chinochino66/humanoid/firmware/README.md

# firmware

## 収録物

| ファイル名 | 内容 | 状態 |
|---|---|---|
| ServoCenter.ino | サーボ中央出し・可動域確認治具 | 再作成版・実機未検証 |
| servo_pin_map.csv | PCA9685チャンネルと軸の対応表 | 再作成版・実測値未記入 |

**重要な注意**：両ファイルは手順書がL-Phase 1の成果物として挙げるものと同名だが、L1当時の原本は紛失している。本ファイルは現行設計（PCA9685 ×2構成）に合わせて2026-08-06に新規作成したものであり、L-Phase 1 の完了記録ではない。実機検証も未実施。実機で動作確認できた時点で、日付と結果をServoCenter.inoのヘッダへ追記すること。詳細は docs/OPEN_ISSUES.md #38 を参照。

## 動作確認の前提

- Adafruit PWM Servo Driver Library v2.4.0以降が必要
- ボードはArduino Mega 2560

## 安全上の注意

- サーボは機構へ取り付ける前に単体で中央出しすること
- ポンプ・高トルクサーボをArduinoの5V端子から給電しないこと
