chinochino66/humanoid/docs/channel_map.md

# チャンネル表 v1（頭部フェーズ）

準拠: `蓮冥頭部 H-Phase 0-24 改訂手順書`（2026-08-03改訂）
電源グループは `power_system.md` と対応。

**構成（制御四層）**

| 層 | 実体 | 役割 | 状態 |
|---|---|---|---|
| 第1層 | 胴体内AIコンピュータ（未選定） | 音声認識・LLM・TTS・視覚・ログ | **未実装**（暫定でノートPCが代行） |
| 第2層 | Arduino Mega | サーボ指令、位置・電流取得、状態機械 | 実装中 |
| 第3層 | 独立安全コントローラ（未選定） | 非常停止・漏水・過電流・過熱・WDT・電源遮断 | **未実装**（暫定でMegaが兼務） |
| 第4層 | LiFePO4 + BMS | 残量・温度監視、低電圧シャットダウン | 未接続 |

⚠ **第3層の兼務は暫定。**Megaがハングすれば安全系も同時に死ぬ。H-Phase 12で分離する。

---

## 1. I²Cアドレスマップ（第2層バス）

| アドレス | デバイス | バス | 設定 |
|---|---|---|---|
| 0x29 | TCS34725（カラー） | ESP32 | 固定 |
| 0x40 | PCA9685 #1 | Mega | ジャンパ無し |
| 0x41 | PCA9685 #2 | Mega | A0ハンダ |
| 0x44 | INA219 #A（レールA監視） | Mega | A1ジャンパ |
| 0x45 | INA219 #B（レールB監視） | Mega | A0＋A1ジャンパ |
| 0x48 | ADS1115（味覚AD） | ESP32 | ADDR→GND |
| 0x49 | ADS1115 増設予約 | ESP32 | ADDR→VDD |

⚠ **INA219のデフォルトは0x40でPCA#1と衝突する。必ず0x44/0x45へ変更してから接続。**

## 2. PCA9685 #1（0x40）— 表情系／レールA（5.8V・micro専用）

| ch | 制御名 | サーボ | 初期角 | パルスmin/max（実測欄） | 備考 |
|---|---|---|---|---|---|
| 0 | upperLip | MG92B | 90° | ／ | 皮膚アンカー荷重あり |
| 1 | cheekRight | MG92B | 90° | ／ | 〃 |
| 2 | cheekLeft | MG92B | 90° | ／ | 〃 |
| 3 | eyebrowRight | SG92R | 90° | ／ | |
| 4 | eyebrowLeft | SG92R | 90° | ／ | |
| 5 | forheadRight | SG92R | 90° | ／ | |
| 6 | forheadLeft | SG92R | 90° | ／ | |
| 7 | eyeX | MG90S | 90° | ／ | 両目左右・共通軸（i2Eyesは左右連動） |
| 8 | eyeY | MG90S | 90° | ／ | 両目上下・共通軸 |
| 9 | eyelidLeft | MG90S | 90° | ／ | |
| 10 | eyelidRight | MG90S | 90° | ／ | |
| 11 | tasteSensorLift | MG92B | 90° | ／ | 味覚プレート昇降 |
| 12-15 | 予備 | — | — | — | 独立視線化(v2)・唾液系の増設枠 |

**表情固定点はJMI-v1（顎交換境界）の外側に置く。**顎モジュールを交換しても表情機構が失われないこと（H-Phase 7完了ゲート）。

## 3. PCA9685 #2（0x41）— 首・顎系／レールB（5.0V・D36V50F5）

| ch | 制御名 | サーボ | 初期角 | 角度リミット | 備考 |
|---|---|---|---|---|---|
| 0 | neckRotate | **保留** | 90° | 小角度から実測 | 単軸駆動ルール適用 |
| 1 | neckUpDown | **保留** | 90° | 90±5°から開始 | 〃 |
| 2 | jaw | MG996R/DS3218（選定中） | 閉=0基準 | 試験15°／**上限20°をハードコード** | 首と同時駆動禁止。機械ストッパー併用 |
| 3 | throatGate | MG92B | **閉位置** | 実測 | **通常時クローズ。非通電時も閉じる機構が必要** |
| 4 | （予約）rollNeckRight | — | — | — | i2の首傾げを将来採用時 |
| 5 | （予約）rollNeckLeft | — | — | — | 〃 |
| 6-15 | 予備 | — | — | — | 唾液系など将来枠 |

⚠ 首サーボは `FutureJaw_MassEnvelope_v0` 確定まで発注しない（`servo_comparison.md` §6）。

## 4. Arduino Mega ピン（第2層）

| ピン | 機能 | 方向 | 備考 |
|---|---|---|---|
| D2 | mouthTrayDetect | IN（PULLUP） | トレー装着スイッチ。未装着＝口内系コマンド拒否 |
| D3 | tankFullSensor | IN（PULLUP） | 回収タンク満水 |
| D4 | **PCA_OE**（#1・#2共通） | OUT | HIGH=全サーボ出力停止。起動時HIGH、中立書込後にLOW |
| D5 | drainPump（MOSFET ch1） | OUT/PWM | ソフトタイマで連続駆動時間を制限 |
| D6 | foodTransferPump（MOSFET ch2） | OUT/PWM | 将来 |
| D7 | washPump（MOSFET ch3） | OUT/PWM | 将来 |
| D8 | **jawModuleID bit0** | IN（PULLUP） | 顎モジュール識別 |
| D9 | **jawModuleID bit1** | IN（PULLUP） | 〃（00=表情顎／01=咀嚼顎／11=未装着） |
| D10 | **安全系ハートビート出力** | OUT | 第3層のWDTへ。停止すれば遮断 |
| D11 | **安全系ステータス入力** | IN | 第3層からの遮断状態通知 |
| D18 | E-STOP状態（NO接点） | IN（PULLUP） | 状態通知のみ。**遮断は第3層が物理的に行う** |
| A0 | 漏水センサー1 | IN | 口内トレー直下 |
| A1 | 漏水センサー2 | IN | 頭蓋内・電装区画 |
| A2 | 漏水センサー3 | IN | 回収タンク周辺 |
| A3 | **基板温度センサー** | IN | 過熱監視 |
| D20/D21 | SDA/SCL | I²C | PCA×2＋INA×2 |
| （予約）D14/D15 | **Serial3 → CAN or RS-485** | — | 第1層との通信。ECI-v1 |
| USB Serial0 | 保守用リンク | — | **通常運転経路に含めない**。開発・更新・ログ回収のみ |

## 5. ESP32 味覚センサノード

| ピン | 機能 | 備考 |
|---|---|---|
| GPIO21/22 | SDA/SCL | ADS1115（0x48）、TCS34725（0x29） |
| ADS1115 A0 | pHモジュール | 校正液3点（4.00/6.86/9.18）で較正 |
| ADS1115 A1 | TDS（KS0429） | |
| ADS1115 A2 | VOC | I²C型なら空けてバス接続 |
| ADS1115 A3 | 予備 | |
| GPIO4 | 防水温度センサー | DS18B20系ならOneWire＋4.7kΩ。**型式要確認** |
| UART | 第1層へ味覚メッセージ送信 | 将来CAN/RS-485へ統合可 |

**TasteCell_v1は交換式とし、将来の脂質/高分子膜センサーアレイを追加できる電極・流路空間を確保する**（H-Phase 11）。

### 味覚JSONスキーマ v2

```json
{
  "ts": 0,
  "raw":        { "ph_mv": 0, "tds_mv": 0, "temp_c": 0, "rgb": [0,0,0], "voc_mv": 0 },
  "calibrated": { "ph": 0.0, "ec_us_cm": 0, "temp_c": 0.0 },
  "estimated":  { "sourness": 0.0, "saltiness": 0.0, "sweetness": 0.0, "aroma": 0.0 },
  "confidence": 0.0,
  "flags":      { "sensor_fault": false, "uncalibrated": false, "rinse_required": false }
}
```

**raw / calibrated / estimated / confidence を分離する。**pHを酸味、導電率をイオン量、VOCを香りの手掛かりとして扱い、**五味そのものと断定しない**（H-Phase 11）。

## 6. 表情プリセット

`neutral` ／ `angry` ／ `suspicious` ／ `thin_smile` ／ `taste_dislike` ／ `taste_approve`

**顎モジュールIDに応じてjawとupperLipの制限値を切り替える**（`JawModule_ProfileSchema_v1`）。プリセット再生は第2層で完結し、第1層が停止していても実行できること。

## 7. 固定安全ロジック（AI・LLMに委譲しない層）

| # | 条件 | 検知 | 固定動作 | 担当層 |
|---|---|---|---|---|
| 1 | 漏水 | A0〜A2 閾値超え | **喉ゲートを閉位置へ駆動 → 完了確認 → OE=HIGH → 全ポンプOFF → アクチュエータ電源遮断** | 第3層 |
| 2 | トレー未装着 | D2 | 口内系コマンド（JAW_OPEN含む）拒否 | 第2層 |
| 3 | タンク満水 | D3 | 食品受入停止。DRAIN系以外の口内系拒否 | 第2層 |
| 4 | E-STOP押下 | 物理NC接点 | **アクチュエータ電源を物理遮断。**手動確認まで再始動禁止 | 第3層 |
| 5 | ポンプ連続駆動超過 | ソフトタイマ | 強制OFF＋詰まり疑いフラグ | 第2層 |
| 6 | レール過電流 | INA219 が2A超×2秒 | 該当レールのサーボ停止 | 第2層→第3層 |
| 7 | **過熱** | A3 が閾値超え | 新規動作禁止 → 中立復帰 → 遮断 | 第3層 |
| 8 | **通信断（第1層）** | 受信タイムアウト | **新規動作禁止。中立保持または力解放** | 第2層 |
| 9 | **ハートビート停止（第2層）** | D10 のWDT | アクチュエータ電源遮断 | 第3層 |
| 10 | **BMS低電圧** | BMS通知 | 新規動作禁止 → ログ保全 → 制御シャットダウン | 第3層 |
| 11 | **モジュールID不明** | D8/D9 | **顎駆動へ電力を供給しない** | 第3層 |
| 12 | 待機タイムアウト | ソフトタイマ | OE=HIGH（保持電流遮断）。復帰は OE=LOW→目標角 | 第2層 |

**#1の順序が重要。**先にOE=HIGHにすると喉ゲートを閉じられなくなる。**閉じてから止める。**

**#4と#9は電気的に第2層から独立していること。**Megaがハングしても働くこと（H-Phase 12完了ゲート）。

## 8. 顎モジュールモード

| モード | 条件 | 顎駆動 |
|---|---|---|
| `EXPRESSION_JAW` | ID=00 | 表情・発話・味見のみ。**咀嚼不可** |
| `TASTE_ONLY` | 任意 | 顎は最小開口。味覚測定のみ |
| `MASTICATION_BENCH` | ID=01 かつ 頭部外 | ベンチ治具でのみ許可 |
| `MASTICATION_INSTALLED` | ID=01 かつ 全安全条件成立 | H-Phase 20以降 |

**表情顎では咀嚼モードへ遷移できない**（H-Phase 13完了ゲート）。

---

## 9. 未決

- [ ] 第3層マイコンの選定とピン割当
- [ ] CAN / RS-485 トランシーバの選定（ECI-v1）
- [ ] 喉ゲートの非通電時閉機構（ばね等）
- [ ] 基板温度センサーの実装位置と閾値
- [ ] 首サーボ確定後、ch0/ch1の角度リミットを実測で埋める
- [ ] パルスmin/max実測欄をキャリブレーション時に記入

## 変更履歴

- **v1 2026-08-03** 改訂手順書へ準拠。制御四層を明記、独立安全コントローラを追加、モジュールID・ハートビート・温度・CAN予約ピンを追加、固定安全ロジックを6→12条件へ拡張（漏水時の喉ゲート閉順序を明記）、味覚JSONスキーマv2と表情プリセットと顎モジュールモードを追加、サーボ型番を荷重帯で分割、レールBを5.0Vへ修正。ファイル名からバージョンを除去
- v0.1 2026-07-29 Eyes i2確定によりPCA#1を4ch削減
- v0 2026-07-28 初版
