chinochino66/humanoid/docs/servo_comparison.md

# サーボ仕様比較 v1（頭部フェーズ／スケール100%）

準拠: `蓮冥頭部 H-Phase 0-24 改訂手順書`（2026-08-03改訂）
採用スケール **100%** のため、InMoov公式指定のトルク基準がそのまま適用できる。

---

## 0. 選定方針

1. **荷重帯でサーボを分ける。**17軸を同一型番で揃える必要はない
2. **首サーボは将来の咀嚼顎質量を織り込むまで確定しない**（§6参照）
3. **公称値には条件がつく。**条件を書かない数値は採用しない
4. 電源はレールA=5.8V／レールB=5.0Vを前提とする（`power_system.md` §4）

---

## 1. 手持ち・到着待ち

| 型番 | 状態 | サイズ級 | 電圧 | ストールトルク | 速度 | 方式 | 重量/寸法 | 割り当て |
|---|---|---|---|---|---|---|---|---|
| MG90S ×4 | 到着待ち | micro | 4.8〜6V | 1.8kg·cm@4.8V／2.2@6V | 約0.1s/60° | アナログ・金属ギア | 13.4g／22.5×12×28.5mm | **目2軸＋瞼2軸に充当** |
| JX PDI-6225MG-300° | 到着待ち | 標準 | 4.8〜6.6V | 19.9kg·cm@4.8V／25.3@6V | 0.21s/60°@6V | デジタル・金属ギア・可動295°（500-2500µs） | 62g／40.5×20.2×38mm | **ハンド指駆動用に確保。頭部に流用しない** |

- 6225MGの「300°」は指の巻き取り量確保のための広角仕様。頭部関節は180°で足り、流用メリットが無く、PCA9685のパルス→角度換算も他と揃わなくなる
- ストール電流は公称なし。目安: micro級 〜0.7A@6V、25kg級 2.5〜3A@6V

## 2. 頭部の必要チャンネルと要求トルク帯（計16ch）

| トルク帯 | チャンネル | 数 |
|---|---|---|
| micro級（〜2.5kg·cm） | eyeX／eyeY／eyelid×2／eyebrow×2／forhead×2 | 8 |
| micro級（〜3.5kg·cm・皮膚荷重あり） | upperLip／cheek×2／throatGate／tasteSensorLift | 5 |
| 中型（10〜20kg·cm） | jaw | 1 |
| 大型（要検討） | neckRotate／neckUpDown | 2 |

**Eyes i2は左右連動構成のため、目2軸＋瞼2軸の計4軸。**独立視線化はi2フレーム外の上位機構であり、v2以降の課題とする。

## 3. InMoov公式指定（Default Hardware Map）

| 部位 | 公式指定 | 公式代替 | 補足 |
|---|---|---|---|
| Neck＋RotHead | HS-805BB ×2 | PDI-HV2060MG | ジャイアントスケール（約66×30×57.6mm）。**首まわりの印刷ホルダはこのサイズ前提** |
| Jaw | HK15298B ×1 | PDI-6221MG（180°版） | 可動は**0〜20°程度まで**（超過で破損リスク） |
| Eyes | SG92R ×2 | DS929HV | 左右連動の2サーボ構成 |
| RollNeck（i2の首傾げ） | HK15298B ×2 | PDI-6221MG（180°版） | 未採用。将来採用ならPCA#2の予備chへ |

- HS-805BB参考値: 19.8kg·cm@4.8V／24.7@6V、アナログ、約152g
- 公式サイトには、JX PDI-6221MG 180°を使用した際にServoAdapter・ServoHorn Adapter・SkullServoFixへ収まらず、SkullServoFixが2mm高くなったという報告がある。**i2Headのサーボ穴は公式指定寸法にぴったり作られている。数mmの差が命取りになる**

## 4. 購入候補比較

| 型番 | 電圧 | トルク | 速度 | 方式 | サイズ | 用途候補 | 備考 |
|---|---|---|---|---|---|---|---|
| **SG92R** | 4.8〜6V | 1.6kg·cm@4.8V | 0.1s/60° | アナログ | micro | 眉・額・瞼 | 公式が目に指定。低荷重軸には十分 |
| **MG92B** | 5〜6.6V | 3.5kg·cm | 0.08s/60° | アナログ・金属ギア | micro | 上唇・頬・喉ゲート・味覚リフト | **高さ31mm（MG90Sより2.5mm高い）。要実測** |
| MG90S | 4.8〜6V | 2.2kg·cm@6V | 0.1s/60° | アナログ・金属ギア | micro | 目・瞼 | 到着待ち4個を充当 |
| MG996R | 4.8〜6.6V | 9.4@4.8V／11@6V | 0.17s/60° | アナログ | 標準 | jaw（最安案） | 個体差大。顎は小角度運用なので十分 |
| DS3218MG | 4.8〜6.8V | 19@5V／21.5@6.8V | 0.16s/60° | デジタル | 標準 | jaw（余裕案） | 防水。5V動作でも19kg·cm |
| DS3225MG級 | 4.8〜6.8V | 21@5V／25@6.8V | 0.15s/60° | デジタル | 標準 | neck候補 | **ジャイアントスケールではない。ホルダ互換要確認** |
| HS-805BB | 4.8〜6V | 24.7@6V | — | アナログ | ジャイアント | neck候補 | 高価・入手性△。印刷パーツにそのまま合う |

⚠ **レールBは5.0V固定。**上表の「@6V」「@6.8V」の値は使えない。**5V時の値で評価すること。**HS-805BBは5V時に約20kg·cm相当まで落ちる。

⚠ 通販の商品説明ではMG90Sのトルクが1.8〜4.8kg·cmまで散らばっている。**ストール電流とデッドバンドまで記載のある出品だけがデータシートを見て書いている。採用値は2.2kg·cm@6V。**

## 5. 割り当て案 v1

| 用途 | ch数 | 使う物 | 追加購入 |
|---|---|---|---|
| 目（eyeX／eyeY） | 2 | 到着待ちMG90S | — |
| 瞼（左右） | 2 | 到着待ちMG90S | — |
| 眉×2・額×2 | 4 | — | **SG92R ×6**（予備2込み） |
| 上唇・頬×2・喉ゲート・味覚リフト | 5 | — | **MG92B ×6**（予備1込み・※高さ実測後） |
| jaw | 1 | — | **MG996R or DS3218 ×2**（予備込み） |
| neckRotate／neckUpDown | 2 | — | **保留（§6）** |
| 制御基板 | — | — | **PCA9685 ×2** |
| 配線 | — | 手持ち5＋到着5 | 首用22AWG＋micro用を追加 |

## 6. 首サーボ選定を保留する理由 ★

**改訂手順書 H-Phase 2 は、将来の咀嚼顎の質量ダミーを載せた許容領域（`FutureJaw_MassEnvelope_v0`）の作成を求めている。**

現在の頭部に加えて、H-Phase 20では以下が追加される。

- 金属サブフレームの咀嚼顎
- 交換式人工歯、舌パドル
- 荷重センサー、人工唾液回路
- 下顎外装・下顎シリコン皮膚

**今の頭部質量だけで首サーボを確定すると、H-Phase 20で首ごと作り直しになる。**手順書の「1からやり直しになる条件」に該当する。

**判定に必要なもの（H-Phase 2で取得する）**

1. 現在の頭部質量と重心位置の実測
2. `FutureJaw_MassEnvelope_v0` による将来質量・重心の想定値
3. 首の回転軸から重心までの距離 → 必要トルクの計算
4. NeckServoHolderV2 / SkullServoFixV5 の実寸とサーボ外形の照合
5. レールB 5.0V動作時のトルク低下（公称6V比で約2割減）の織り込み

**上記が揃うまで、首サーボは発注しない。**

## 7. 顎の角度リミット

| 項目 | 値 | 根拠 |
|---|---|---|
| 試験手順 | 閉口 → 5° → 10° → **15°** | 改訂手順書 H-Phase 5 |
| ハードコード上限 | **20°** | InMoov公式注記（超過で破損リスク） |
| 同時駆動 | 首との同時駆動を禁止 | レールB電流予算 |

**試験は15°まで。上限20°はソフトウェア側の絶対リミット。**両者を混同しないこと。加えて**機械ストッパーとソフトウェア制限の両方**を働かせる（H-Phase 5完了ゲート）。

## 8. 決めること

1. **MG92Bの高さ31mmを、印刷済みサーボマウントに実測で当てる**（入らなければSG92RかMG90Sへ変更）
2. 頭部質量・重心の実測と `FutureJaw_MassEnvelope_v0` の作成 → 首サーボ確定
3. jawをMG996R（安価）とDS3218（余裕）のどちらにするか
4. 将来の咀嚼顎アクチュエータは本表の対象外。H-Phase 15の要求仕様策定後に別途選定する

---

## 変更履歴

- **v1 2026-08-03** 改訂手順書へ準拠。Eyes i2確定によりmicro級を17→13軸へ、荷重帯でMG92B/SG92Rに分割、レールB5V化に伴い評価電圧を修正、首サーボ選定を将来顎質量エンベロープ確定まで保留、顎の試験角度と上限を分離。ファイル名からバージョンを除去
- v0 2026-07-28 初版

参考: inmoov.fr/default-hardware-map ／ inmoov.fr/neck-and-jaw ／ inmoov.fr/headi2
