chinochino66/humanoid/docs/reference/servo_datasheets.md

# サーボ諸元表

版数: v1.6
改訂日: 2026-08-06
準拠文書: 器創造計画 2026-2033（改訂基準日 2026-08-03）
系統タグ: 系統非依存（参照専用の仕様表。軸割当・系統タグはここには書かない）
変更履歴:
- v1 2026-08-04 旧H-Phase体系文書 `docs/archive/2026-08-03_servo_comparison_hphase.md` から、軸割当を含まない純粋な仕様表として新規分離。全数値をメーカー公式ページまたは特定リスティングの一次情報で再確認し、出典URL・取得日を付した。データシートに5.0V欄が無い機種は4.8V/6.0V（または5.0V/6.8V）からの線形補間であることを明記した。
  - JX PDI-1109MGを追加。InMoov公式 `inmoov.fr/eyes-i2/` の指定サーボであることを一次情報で確認（`docs/decisions/2026-08-04_eye_axis_count_correction.md` 参照）。
- v1.2 2026-08-06 HS-805BBの項目へ外形実寸（65.6×29.6mm、myminifactoryのコミュニティ情報。公式チュートリアル記載値66×30×57.6mmとは別記）を追記し、SkullServoFixV5ポケット実測値（65.7/29.3、2026-08-06）との整合を記録した【2026-08-06訂正：当初NeckServoHolderV2と記載したが誤り】。JX PDI-6221MG（顎駆動、InMoov公式i2Head指定）を新規追加。トルク・速度・電流・パルス仕様は未確認のまま登録した。
- v1.3 2026-08-06 JX PDI-6221MGへストールトルク（4.8V: 17.25kg·cm／6.0V: 20.32kg·cm／5.0V線形補間の推定値: 約17.8kg·cm）、動作速度（4.8V: 0.18秒/60°／6.0V: 0.16秒/60°）、外形寸法（40.5×20.2×38mm）、重量（62g）、ベアリング（2BB）を追記した。出典は販売店の商品説明（2026-08-06取得）でありメーカー公式データシートによる確認は未実施。本製品には動作角120°／180°／360°の別モデルが存在し、公式指定は180°だが現物（2026-08-06調達済み）が180°版であるかの確認は未実施（`docs/OPEN_ISSUES.md` #11 で継続管理）。

**本書の位置づけ**：この文書は各サーボ型番の仕様のみを扱う。どの軸にどのサーボを割り当てるかは `docs/L/servo_assignment_L.md`（L系）・`docs/R/reserved_axes.md`（R系・在庫紐付けのみ）・`docs/S/bench_axes_S3S4.md`（S系）を参照すること。

**数値の扱い**：
- データシート値と実測値は列を分ける。実測値欄が空の場合は「未実測」。
- 出典が確認できない数値は「未確認」と書く。他サイトからの孫引きは避ける。
- レールA=5.8V／レールB=5.0Vで運用するため、5.0V時の値を必ず併記する。メーカー公式に5.0V欄が無い場合は隣接する公式値からの線形補間とし、「補間・未実測」と明記する。補間は同一メーカー資料内の2点間の直線近似であり、実際のトルク–電圧特性が線形であることを保証しない。

---

## 1. 基本定格

| 型番 | メーカー | 動作電圧範囲 | ギア材質 | 外形 L×W×H | 質量 | 出典URL | 取得日 |
|---|---|---|---|---|---|---|---|
| MG90S | TowerPro | 4.8–6.6V | 金属（アルミ6061-T6、公式記載） | 22.8×12.2×28.5mm（公式ページのA-K多点寸法表の読み取りに複数系統の値があり、独立した複数サイトで一致するこの値を採用。公式図面での再確認が必要） | 13.4g | https://towerpro.com.tw/product/mg90s-3/ | 2026-08-04 |
| SG92R | TowerPro | 4.8V（公式は単一電圧表記のみ。上限側の公式記載なし） | POM＋カーボンファイバー | 34.5×22.8×26.7mm（公式A/B/C寸法） | 9g | https://towerpro.com.tw/product/sg92r-7/ | 2026-08-04 |
| MG92B | TowerPro | 5.0–6.6V | 金属 | 22.8×12×31mm | 13.8g | https://towerpro.com.tw/product/mg92b/ | 2026-08-04 |
| MG996R | TowerPro | 4.8–6.6V | 金属 | 40.7×19.7×42.9mm | 55g | https://towerpro.com.tw/product/mg996r/ | 2026-08-04 |
| DS3218MG | ANNIMOS（DS3218系OEM品。ベンダーにより仕様表記が異なる。下記は当該リスティングの記載値） | 出典により4.8–7.2V／5–6.8V等の表記差あり | 金属（フルメタルギア、防水） | 40×20×40.5mm | 60g | https://www.amazon.com/DS3218-Digital-Servo-Torque-Waterproof/dp/B07TKTQ2NZ | 2026-08-04 |
| HS-805BB | Hitec | 4.8–6.0V | ギアはナイロン、モータはカーボンブラシ | 66×30×57.6mm | 152g（5.36oz） | 一次PDF: https://www.hiteccs.com/public/uploads/data_sheet/HS-805BB-DataSheet-1642819052.pdf（機械抽出不可）／小売サイト記載値で代用: https://www.robotshop.com/products/hs-805bb-giant-scale-servo-motor | 2026-08-04 |
| JX PDI-1109MG | JX Servo | 4.8–6.0V | 金属（20T） | 23.2×12.0×24.8mm | 10g | https://inmoov.fr/eyes-i2/（InMoov公式指定。「4 servos JX PDI 1109MG」「avoid using cheap SG90, they won't last long」と明記）／数値照合: https://hobbyking.com/en_us/jx-pdi-1109mg-metal-gear-digital-micro-servo-2-5kg-0-10sec-10g.html | 2026-08-04 |
| JX PDI-6221MG | 未確認 | 未確認 | 未確認 | 40.5 × 20.2 × 38mm（標準サイズサーボ） | 62g | InMoov公式 i2Head チュートリアル（顎駆動サーボとして指定。動作角180°の記載あり） https://inmoov.fr/headi2/／外形・質量は販売店の商品説明（2026-08-06取得、メーカー公式データシートによる確認は未実施） | 2026-08-06 |

**HS-805BB 外形寸法の実寸との照合**

- 外形寸法（公式チュートリアル記載）: 66 × 30 × 57.6 mm
- 外形寸法（実寸）: 65.6 × 29.6 mm
  出典: myminifactory「InMoov Neck Servo Adaptor」(Brian Stott) の記述
  「HS805BB servo motors of dimension - 29.6mm X 65.6mm」
  **注記: 公式一次情報ではなくコミュニティ情報である。**
  ただし SkullServoFixV5 のポケット実測値（65.7 / 29.3、2026-08-06）と整合しており、
  設計上の想定サーボがHS-805BBであることの裏付けとなる（`docs/L/print_record_L.md` §3）。
  Hitec公式データシートによる寸法の確認は未実施。
  なお NeckServoHolderV2（外形 55.0 × 58.5 × 22.0 mm）にはHS-805BBは収まらない。
  首上下軸のサーボは未確定である（`docs/OPEN_ISSUES.md` #39）。
  **【2026-08-06 訂正】** 上記の判断は誤りであった。NeckServoHolderV2.stlには同一形状のL字ブラケットが2個含まれており、
  スライサー表示の外形55.0×58.5×22.0mmは2個分の合計である（1個あたり約55.0×28.0×22.0mm）。
  構造はサーボを内包する箱ではなく左右から挟むブラケットであるため、厚み22mmはサーボ高さの制約にならない。
  InMoov公式 Hardware and BOM（https://inmoov.fr/default-hardware-map/、取得日2026-08-06）の
  「2x Hitec HS805BB HEAD (up/down, right/left)」の記載により、首上下軸もHS-805BBで確定した（`docs/OPEN_ISSUES.md` #39）。

公式用途: 首回転・首上下（InMoov公式 Hardware and BOM「2x Hitec HS805BB HEAD (up/down, right/left)」、
https://inmoov.fr/default-hardware-map/、取得日2026-08-06）。
公式が挙げる代替: PDI-HV2060MG、HS5805MG、HK15338（HK15338はモーター極性が逆で
分解して180°回転させる必要があり、抵抗の追加も要すると設計者が回答している）。

**JX PDI-6221MGについて**

InMoov公式 i2Head チュートリアルにより、顎駆動（公式指定）および首回転の小型サーボ代替
（ServoAdapter/ServoHornAdapter併用時）に用いられることが判明した。
出典: InMoov公式 i2Head チュートリアル（inmoov.fr/headi2/）。
電流・パルス仕様は未確認（下表参照）。トルク・速度・外形寸法・重量・ベアリングは以下のとおり判明した。

- ストールトルク（4.8V）: 17.25 kg·cm
- ストールトルク（6.0V）: 20.32 kg·cm
- **5.0V時（線形補間による推定値）: 約17.8 kg·cm**
- 動作速度（4.8V）: 0.18秒/60°
- 動作速度（6.0V）: 0.16秒/60°
- 外形寸法: 40.5 × 20.2 × 38mm（標準サイズサーボ）
- 重量: 62g
- ベアリング: 2BB
- 出典: 販売店の商品説明（2026-08-06取得）。**メーカー公式データシートによる確認は未実施。**

**⚠ 本製品には動作角の異なる複数のモデルが存在する（120°／180°／360°）。**
公式i2Headチュートリアルの指定は**180°**である。
2026-08-06に1個を調達済みだが、**現物が180°版であるかの確認は未実施**。
到着後に必ず確認し、結果を本項へ追記すること。
`docs/OPEN_ISSUES.md` #11 で継続管理する。

公式用途: 顎（HK15298Bの代替として設計者が明示的に許容。「make sure to get 180°」との注意付き）、
RollNeck（首傾げ、オプション機構）。

**HK15298Bについて**

判明している情報のみ記載し、未確認の項目は「未確認」と明記する。

- 用途: 顎（公式BOM指定）、RollNeck ×2（公式BOM指定）、手指 ×10（公式BOM指定）
- トルク: 約20kg·cm（設計者の記述「HK15298B (Strong torque 20kg , no noise, 90degree)」による。電圧条件の記載なし）
- 動作角: 90°
- 外形寸法・電流・5V時特性: 未確認
- 入手性: 設計者が2022年に「入手困難」との問い合わせに対しJX-PDIシリーズを推奨している
- 出典: https://inmoov.fr/default-hardware-map/（取得日2026-08-06）
- **本プロジェクトでは採用しない**（顎はJX PDI-6221MGを採用。RollNeckは未採用）

## 2. トルク・速度

| 型番 | トルク@4.8V | トルク@5.0V | トルク@6.0V | 速度 | 実測値欄 |
|---|---|---|---|---|---|
| MG90S | 1.8kg·cm（公式） | 約1.84kg·cm（4.8V/6.6V公式値間の線形補間、未実測） | 約2.07kg·cm（同補間、未実測） | 0.10s/60°@4.8V／0.08s/60°@6.0V（公式。トルクのアンカー電圧が6.6Vなのに対し速度のアンカーは6.0Vと異なる点に注意） | 未実測 |
| SG92R | 2.5kg·cm（公式） | 未確認（公式が4.8V単一値のみで上限側アンカーが無く補間不可） | 未確認（同） | 0.1s/60°@4.8V（公式） | 未実測 |
| MG92B | 未確認（公式は5.0V起点） | 3.1kg·cm（公式） | 3.5kg·cm（公式） | 0.13s/60°@5.0V／0.08s/60°@6.0V（公式） | 未実測 |
| MG996R | 9.4kg·cm（公式） | 約9.67kg·cm（4.8V/6.0V公式値間の線形補間、未実測） | 11kg·cm（公式） | 0.19s/60°@4.8V／0.15s/60°@6.0V（公式） | 未実測 |
| DS3218MG | 未確認（当該リスティングに記載なし） | 19kg·cm（当該リスティング記載） | 約20.4kg·cm（5.0V/6.8V記載値間の線形補間、未実測。アンカー電圧が5.0V・6.8Vであり4.8V/6.0Vの慣例と異なる点に注意） | 未確認（当該リスティングに速度記載なし） | 未実測 |
| HS-805BB | 19.8kg·cm（公式値、小売サイト記載） | 約20.6kg·cm（4.8V/6.0V公式値間の線形補間、未実測。`docs/archive/2026-08-03_servo_comparison_hphase.md` の「5V時に約20kg·cm相当」という記述と整合） | 24.7kg·cm（公式値、小売サイト記載） | 0.19s/60°@4.8V／0.14s/60°@6.0V | 未実測 |
| JX PDI-1109MG | 2.2kg·cm（複数リテール一致値） | 約2.25kg·cm（4.8V/6.0V値間の線形補間、未実測） | 2.5kg·cm（複数リテール一致値） | 0.12s/60°@4.8V／0.10s/60°@6.0V | 未実測 |
| JX PDI-6221MG | 17.25kg·cm（販売店記載、メーカー公式未確認） | 約17.8kg·cm（4.8V/6.0V記載値間の線形補間、未実測） | 20.32kg·cm（販売店記載、メーカー公式未確認） | 0.18s/60°@4.8V／0.16s/60°@6.0V（販売店記載） | 未実測 |

## 3. 電流

| 型番 | 無負荷電流 | 動作電流 | ストール電流 | 実測値欄 |
|---|---|---|---|---|
| MG90S | 未確認（TowerPro公式に電流記載なし） | 未確認 | 未確認（`docs/archive/2026-08-03_servo_comparison_hphase.md` にmicro級目安0.7A@6Vの記載はあるが型番固有値ではない） | 未実測 |
| SG92R | 未確認（TowerPro公式に電流記載なし） | 未確認 | 未確認 | 未実測 |
| MG92B | 未確認（TowerPro公式に電流記載なし） | 未確認 | 未確認 | 未実測 |
| MG996R | 10mA（公式。電圧条件の明記なし） | 170mA（公式。電圧条件の明記なし） | 1400mA（公式。電圧条件の明記なし） | 未実測 |
| DS3218MG | 4mA@5.0V（当該リスティング記載） | 未確認（無負荷回転時の電流記載なし） | 1.5A@5.0V／1.8A@6.8V（当該リスティング記載） | 未実測 |
| HS-805BB | 8.0mA（待機、小売サイト記載。Hitec公式PDFは機械抽出不可のため未検証） | 700mA（無負荷回転時、同上） | 未確認（メーカー非公表。`docs/archive/2026-08-03_servo_comparison_hphase.md` に25kg級目安2.5〜3A@6Vの記載はあるが型番固有値ではない） | 未実測 |
| JX PDI-1109MG | 未確認（inmoov.fr／小売サイトとも電流記載なし） | 未確認 | 未確認（micro級目安0.7A@6Vの一般値はあるが型番固有値ではない） | 未実測 |
| JX PDI-6221MG | 未確認 | 未確認 | 未確認 | 未実測 |

## 4. パルス仕様

| 型番 | パルス幅範囲 | 周期 | 回転角 | 実測値欄 |
|---|---|---|---|---|
| MG90S | 未確認（公式に記載なし） | 未確認 | 未確認（通販説明では180°表記が一般的だが未確認） | 未実測 |
| SG92R | 未確認 | 未確認 | 未確認（同上） | 未実測 |
| MG92B | 未確認 | 未確認 | 90°（片側45°）、フルトラベル時は360°まで可（公式記載） | 未実測 |
| MG996R | 未確認 | 未確認 | 未確認（通販説明では180°表記が一般的だが未確認） | 未実測 |
| DS3218MG | 未確認 | 未確認 | 270°（当該リスティング記載） | 未実測 |
| HS-805BB | 未確認 | 未確認 | 未確認（一般的なアナログサーボの可動域だが型番固有の公式記載は未確認） | 未実測 |
| JX PDI-1109MG | 未確認 | 未確認 | 未確認（一般的なマイクロデジタルサーボの可動域だが型番固有の公式記載は未確認） | 未実測 |
| JX PDI-6221MG | 未確認 | 未確認 | 180°（InMoov公式 i2Head チュートリアル記載） | 未実測 |

**パルス幅範囲・周期が「未確認」の型番が多い理由**：多くの安価なアナログ/デジタルRCサーボは、メーカー公式ページに標準的なPWM値（目安 500〜2400µs、周期20ms）を明記しない。業界慣習として広く使われる値であっても、当該型番のデータシートに明記が無い限り本書では「未確認」として扱う。PCA9685のパルス値は実測で較正すること（`docs/L/channel_map_L.md` 側で扱う）。

---

## 変更履歴

- **v1 2026-08-04** 旧H-Phase体系文書から軸割当を含まない仕様表として新規分離。数値をメーカー公式ページ・リスティングの一次情報で再確認。
- **v1.1 2026-08-06** `docs/L/channel_map_L2.md`・`docs/L/servo_assignment_L2.md` のリネームに伴い、本書内の相互参照を `docs/L/channel_map_L.md`・`docs/L/servo_assignment_L.md` へ更新した（内容の変更はない）。
- **v1.2 2026-08-06** HS-805BBへ外形実寸（65.6×29.6mm、myminifactoryのコミュニティ情報）を追記し、SkullServoFixV5ポケット実測値（65.7/29.3、2026-08-06）との整合を記録した【2026-08-06訂正：当初NeckServoHolderV2と記載したが誤り】。JX PDI-6221MG（InMoov公式i2Head指定の顎駆動サーボ、動作角180°）を新規追加。トルク・速度・電流・パルス幅は未確認。
- **v1.3 2026-08-06** JX PDI-6221MGへトルク（ストール4.8V/6.0V・5.0V線形補間推定値）、速度（4.8V/6.0V）、外形寸法、重量、ベアリングを追記した（出典: 販売店の商品説明、メーカー公式データシートによる確認は未実施）。動作角の異なる複数モデル（120°／180°／360°）が存在し、現物（2026-08-06調達済み）が公式指定の180°版であるかの確認が未実施であることを記録した（`docs/OPEN_ISSUES.md` #11）。
- **v1.4 2026-08-06** HS-805BB実寸の裏付けとしていたポケット実測の部品名を訂正。実測した部品はNeckServoHolderV2ではなくSkullServoFixV5であった。NeckServoHolderV2（外形55.0×58.5×22.0mm）にはHS-805BBが収まらず、首上下軸のサーボは未確定である旨を追記した（`docs/OPEN_ISSUES.md` #39）。
- **v1.5 2026-08-06** v1.4の「NeckServoHolderV2にHS-805BBは収まらない」という判断を訂正。NeckServoHolderV2.stlに同一形状のL字ブラケットが2個含まれており、スライサー表示の外形55.0×58.5×22.0mmは2個分の合計（1個あたり約55.0×28.0×22.0mm）であったため、厚み22mmはサーボ高さの制約にならないと判明した。InMoov公式 Hardware and BOMにより首上下軸もHS-805BBで確定した旨を追記した（`docs/OPEN_ISSUES.md` #39）。
- **v1.6 2026-08-06** HS-805BBへ公式用途（首回転・首上下）と公式が挙げる代替（PDI-HV2060MG、HS5805MG、HK15338）を追記した。JX PDI-6221MGへ公式用途（顎の代替、RollNeck）を追記した。新規にHK15298Bの項目を追加した（顎・RollNeck・手指の公式指定サーボだが本プロジェクトでは不採用、`docs/OPEN_ISSUES.md` #11）。

## 参照一覧

| 資料 | URL | 取得日 |
|---|---|---|
| TowerPro MG90S 製品ページ | https://towerpro.com.tw/product/mg90s-3/ | 2026-08-04 |
| TowerPro SG92R 製品ページ | https://towerpro.com.tw/product/sg92r-7/ | 2026-08-04 |
| TowerPro MG92B 製品ページ | https://towerpro.com.tw/product/mg92b/ | 2026-08-04 |
| TowerPro MG996R 製品ページ | https://towerpro.com.tw/product/mg996r/ | 2026-08-04 |
| ANNIMOS DS3218 製品リスティング（Amazon） | https://www.amazon.com/DS3218-Digital-Servo-Torque-Waterproof/dp/B07TKTQ2NZ | 2026-08-04 |
| Hitec HS-805BB 一次データシートPDF（機械抽出不可、参照用） | https://www.hiteccs.com/public/uploads/data_sheet/HS-805BB-DataSheet-1642819052.pdf | 2026-08-04 |
| Hitec HS-805BB 記載仕様（小売サイト、上記PDF未検証分の代用） | https://www.robotshop.com/products/hs-805bb-giant-scale-servo-motor | 2026-08-04 |
| InMoov Eyes i2（JX PDI-1109MG指定、SG90級非推奨の警告） | https://inmoov.fr/eyes-i2/ | 2026-08-04 |
| JX PDI-1109MG 記載仕様（小売サイト、トルク・速度・寸法の照合用） | https://hobbyking.com/en_us/jx-pdi-1109mg-metal-gear-digital-micro-servo-2-5kg-0-10sec-10g.html | 2026-08-04 |
| InMoov Head i2（顎駆動サーボ JX PDI-6221MG・動作角180°の指定根拠） | https://inmoov.fr/headi2/ | 2026-08-06 |
| myminifactory「InMoov Neck Servo Adaptor」(Brian Stott)（HS-805BB実寸65.6×29.6mmの記載。※公式一次情報ではなくコミュニティ情報） | ローカル参照（URL未取得、記述内容のみタスク指示より転記） | 2026-08-06 |
| 旧文書 `docs/archive/2026-08-03_servo_comparison_hphase.md` | ローカルリポジトリ内 | 2026-08-03 |
