chinochino66/humanoid/docs/decisions/2026-08-04_eye_axis_count_correction.md

# 決定記録：目の軸数誤り（4軸誤認）の訂正

版数: v1.1
改訂日: 2026-08-06
準拠文書: 器創造計画 2026-2033（改訂基準日 2026-08-03）
系統タグ: 全系統（決定記録。L系文書群に波及）
変更履歴:
- v1 2026-08-04 新規作成

## 判断日

2026-08-04

## 誤りの内容

L/R/S/M体系への移行時（2026-08-04、コミット1〜7）、L2 InMoov頭部の目関連軸を「eyeX／eyeY（両目共通2軸）＋eyelidLeft／eyelidRight（瞼2軸）＝計4軸」として `docs/L/channel_map_L.md`・`docs/L/servo_assignment_L.md`・`docs/S/power_tree.md` に記載していた。

これは誤りだった。正しくは、InMoov公式のi2Eyes機構は**片目あたり4サーボ（眼球X/Y・上瞼・下瞼）×左右＝計8軸、かつ左右は機械的に連動せずソフトウェア同期**である。

## 発見経緯

「蓮冥頭部 開発手順書 Version 2.0」の部品表が「瞼×4→SG92R」としていたのに対し、リポジトリは瞼2軸（eyelidLeft／eyelidRight）としており、数量の不一致が生じていた。この不一致を一次情報で確認する過程で、`inmoov.fr/eyes-i2/` を直接確認した結果、瞼だけでなく眼球側も含めて軸数の誤認があったことが判明した（旧「eyeX/eyeY共通2軸」自体が誤りであり、正しくは眼球も左右独立4軸）。

**教訓（軸数確認の手順）**：当初は瞼の軸数（2か4か）についてWeb検索・AI要約で確認しようとしたが、`inmoov.fr/eyes-i2/` と `inmoov.fr/headi2/` の記述に見かけ上の矛盾があり（前者は「2 servos drive the eyelids」、後者はMyRobotLabの4チャンネル名を列挙）、一度は「未確認」として `docs/OPEN_ISSUES.md` #30 へ登録した。その後、部品表の見出し（「i2Eyes printed parts for **1 Right Eye**」＝片目分の記載であること）とネジ本数（3×10mmネジ8本＝片目4サーボ分の固定具と一致）まで踏み込んで確認したことで、誤認が解けた。

## 正しい軸数と根拠

出典: `inmoov.fr/eyes-i2/`、取得日 2026-08-04

- 部品表の見出しは「i2Eyes printed parts for 1 Right Eye」＝片目分の記載である
- 片目あたり4サーボ（main baseに2個＝眼球X/Y、side baseに2個＝上瞼・下瞼）
- 3×10mmネジ8本（main base 4本＋side base 4本）が片目4サーボの固定数と一致する
- 両目で計8サーボ。**眼球4軸・瞼4軸**
- 公式指定サーボは **JX PDI-1109MG**（「4 servos JX PDI 1109MG」と明記）
- 公式は「安価なSG90は避けろ、長持ちしない（avoid using cheap SG90, they won't last long）」と明記している
- i2Eyesは**左右独立サーボ**であり、機械的な連動ではなく**MyRobotLab側のソフトウェア同期**で左右を揃える設計である（作者Gael Langevinの記載）

## 波及した文書一覧

| 文書 | 変更内容 |
|---|---|
| `docs/L/channel_map_L.md` | L系チャンネル数を7ch→11ch（目8＋首2＋顎1）へ拡張。eyeX/eyeYの「両目左右共通軸」記述を削除し、eyeLeftX／eyeLeftY／eyeRightX／eyeRightY／eyelidLeftUpper／eyelidLeftLower／eyelidRightUpper／eyelidRightLowerの8ch（ch7-10, 12-15）を追加。空きチャンネル集計を再計算（PCA9685 #1は空きゼロに） |
| `docs/L/servo_assignment_L.md` | 対象軸を7軸→11軸へ拡張。候補型番にJX PDI-1109MGを追加し5.0V時トルクを一次情報で確認。SG92R使用の寿命リスクとMG90S×4本の不足を明記 |
| `docs/S/power_tree.md` | レールAの2026年実装範囲を4ch→8chへ修正。§6.1電流予算・§6.2稼働時間（定常約6.1時間→約4.7時間）・§7-5 PTC電圧降下を再計算。理論上限電流が2.8A→5.6Aとなり、LM2596の実用2A枠を大きく超えることを明記 |
| `docs/reference/servo_datasheets.md` | JX PDI-1109MGの諸元を新規追加（一次情報＋小売サイト照合） |
| `docs/OPEN_ISSUES.md` | #30を「未確認」から「解決済み」へ更新。新規に#31（目サーボ4本の追加調達、影響度高）・#32（左右独立サーボのソフトウェア同期実装、影響度中）・#33（瞼へのSG92R使用可否、影響度中）を追加 |

## 再発防止

- **軸数・数量の確認は、部品表の見出しの適用範囲（片目分か両目分か等）まで確認する。**「瞼×4」のような数量記載だけでなく、それが片側分か両側分かを取り違えると、実際の軸数を過小評価する。
- **組立手順のネジ本数・固定具数など、数量が独立に裏付けられる情報と突き合わせる。**本件では「3×10mmネジ8本＝片目4サーボ分」というネジ本数が、サーボ本数の傍証として機能した。数量の食い違いに気づいた際は、Web検索の要約だけで終わらせず、可能な限りこうした独立した裏付けを探すこと。
- **一次情報間で見かけ上の矛盾がある場合、「未確認」で済ませる前に、より詳細な記述（見出し・注記・数量根拠）まで読み込む。**本件では `eyes-i2/` と `headi2/` の記述の粒度の違い（ハードウェア台数 vs ソフトウェアチャンネル名）が矛盾に見えていただけで、実際には矛盾していなかった。

---

## 変更履歴

- **v1 2026-08-04** 新規作成。目の軸数誤り（4軸→8軸）の訂正記録。
- **v1.1 2026-08-06** `docs/L/channel_map_L2.md`・`docs/L/servo_assignment_L2.md` のリネームに伴い、本書内の相互参照を `docs/L/channel_map_L.md`・`docs/L/servo_assignment_L.md` へ更新した（内容の変更はない）。

## 参照一覧

| 資料 | URL | 取得日 |
|---|---|---|
| InMoov Eyes i2 | https://inmoov.fr/eyes-i2/ | 2026-08-04 |
| InMoov Head i2 | https://inmoov.fr/headi2/ | 2026-08-04 |
| `docs/L/channel_map_L.md` | ローカルリポジトリ内 | 2026-08-04 |
| `docs/L/servo_assignment_L.md` | ローカルリポジトリ内 | 2026-08-04 |
| `docs/S/power_tree.md` | ローカルリポジトリ内 | 2026-08-04 |
| `docs/reference/servo_datasheets.md` | ローカルリポジトリ内 | 2026-08-04 |
| `docs/OPEN_ISSUES.md` | ローカルリポジトリ内 | 2026-08-04 |
