chinochino66/humanoid/docs/S/i2c_address_map.md

# I²Cアドレスマップ

版数: v1.1
改訂日: 2026-08-06
準拠文書: 器創造計画 2026-2033（改訂基準日 2026-08-03）
系統タグ: S（安全・制御・知覚。頭部全体の第2層バス構成）
変更履歴:
- v1 2026-08-04 `docs/S/bench_axes_S3S4.md` §6で「担当文書未確定」としていたI²Cアドレスマップの全体像を新規文書として分離。PCA9685のAll Callアドレス重複の扱い（`docs/OPEN_ISSUES.md` 登録項目）を整理し、空きアドレス帯を明示した。

**本書の位置づけ**：頭部第2層（Arduino Mega）バス上のI²Cデバイス全体のアドレス割当を扱う。軸割当は `docs/L/channel_map_L.md`（L系）・`docs/R/reserved_axes.md`（R系）・`docs/S/bench_axes_S3S4.md`（S系）を参照。電源レール・電流監視の詳細は `docs/S/power_tree.md` を参照。

---

## 1. アドレス一覧

| アドレス | デバイス | バス | 用途 | 設定 |
|---|---|---|---|---|
| 0x29 | TCS34725（カラーセンサー） | ESP32 | 味覚ノード | 固定（変更不可） |
| 0x40 | PCA9685 #1 | Mega | サーボ制御（L系目・瞼／R系予約／S系tasteSensorLift） | ジャンパ無し（工場出荷時デフォルト） |
| 0x41 | PCA9685 #2 | Mega | サーボ制御（L系首・顎／S系throatGate） | A0ハンダジャンパを閉じる |
| 0x44 | INA219 #A（レールA電流監視） | Mega | `docs/S/power_tree.md` §5 | A1ジャンパを閉じる |
| 0x45 | INA219 #B（レールB電流監視） | Mega | `docs/S/power_tree.md` §5 | A0＋A1ジャンパを閉じる |
| 0x48 | ADS1115（味覚AD） | ESP32 | pH・TDS・VOC | ADDRピン→GND |
| 0x49 | ADS1115 増設予約 | ESP32 | 将来センサー追加用 | ADDRピン→VDD |
| 0x70 | PCA9685 #1／#2 共通 All Call（工場出荷時デフォルト有効） | Mega | §3参照。**両基板が同時応答する** | 無効化を推奨（§3） |

**INA219のデフォルトアドレスは0x40であり、PCA9685 #1と衝突する。**必ずA1ジャンパ（0x44）／A0+A1ジャンパ（0x45）へ変更してから接続すること。

## 2. 部品ごとのジャンパ・ハンダ変更箇所

| デバイス | 変更箇所 | 変更前（工場出荷時） | 変更後 |
|---|---|---|---|
| PCA9685 #1 | A0〜A5ジャンパパッド | 全開放（アドレス0x40） | **変更不要**（そのまま0x40として使用） |
| PCA9685 #2 | A0ジャンパパッド | 全開放（アドレス0x40） | A0パッドをハンダ短絡 → 0x41 |
| INA219 #A | A0・A1ジャンパ | 全開放（アドレス0x40、デフォルト） | A1ジャンパを短絡 → 0x44 |
| INA219 #B | A0・A1ジャンパ | 全開放（アドレス0x40、デフォルト） | A0・A1ジャンパを両方短絡 → 0x45 |
| ADS1115（味覚AD） | ADDRピン結線 | 未結線（フローティング、非推奨） | GNDへ結線 → 0x48 |
| ADS1115（増設予約） | ADDRピン結線 | 未結線 | VDDへ結線 → 0x49 |
| TCS34725 | なし | 0x29固定 | 変更不可（設定箇所なし） |

## 3. PCA9685のAll Callアドレス重複について

PCA9685は、個別アドレス（0x40／0x41）に加えて、**工場出荷時デフォルトで All Call アドレス 0x70 にも応答する。**MODE1レジスタ（0x00番地）のALLCALLビット（bit0）が出荷時 `1`（有効）のため、**本システムのPCA9685 #1・#2は両方とも0x70に同時応答する状態にある。**

### (a) 両基板同時応答の可否

0x70宛のI²C書き込みは、**PCA9685 #1・#2の両方に同時に作用する。**これは以下の場合に危険となり得る：

- ソフトウェアのバグや配線ミスで意図せず0x70へ書き込んだ場合、L系（目・瞼・首・顎）とR系予約・S系（喉ゲート等）の両基板のサーボが**同時に**動く
- E-STOP復帰時など、特定の基板のみへ中立値を書き込むつもりが、0x70経由で両基板に書き込まれる

一方、起動シーケンス（`docs/S/power_tree.md` §8）の「全chに中立値を書き込む」ステップのように、**両基板に同一内容を一括で書き込みたい場面では有用**な面もある。ただし、この起動シーケンスでは元々OE（出力イネーブル）ピンD4が両基板共通のハードウェア結線であり、出力停止・再開はI²Cを介さずピンレベルで既に両基板同時に制御できている。**All Callが無ければ起動シーケンスが成立しないわけではない。**

**本書の判断**：意図しない同時書き込みのリスクが、起動時一括書き込みの利便性を上回ると判断し、**両基板のAll Callを無効化することを推奨する。**

### (b) 無効化手順

Mega初期化時（OE=HIGHの間、§出力停止状態）に、両基板それぞれのMODE1レジスタのALLCALLビット（bit0）を`0`に書き込む。個別アドレス（0x40／0x41）でMODE1レジスタへアクセスするため、無効化そのものは基板ごとに独立して行える。

**この初期化コードは本書執筆時点で未実装。**`docs/OPEN_ISSUES.md` へ「PCA9685 All Callアドレス2枚重複の扱い」として登録済みの項目に対応する実装タスクとする。

### (c) Sub-callアドレスの扱い

PCA9685はAll Callの他に、Sub1／Sub2／Sub3の3つのグループアドレス（MODE1レジスタのSUB1／SUB2／SUB3ビット、デフォルトアドレスはそれぞれ0x71／0x72／0x74）を持つ。**これらは工場出荷時デフォルトで無効（ビット=0）であり、現状は両基板とも応答しない。**

将来、特定チャンネル群を同期駆動する目的でSub-callを有効化する場合、**両基板が同一のデフォルトアドレスに設定されると、All Callと同じ「両基板同時応答」の問題が再発する。**Sub-callを使う場合は、基板ごとに異なるSUBADRレジスタ値へ変更すること。本書時点では未使用（無効のまま）とし、有効化する際は本書を更新すること。

## 4. 空きアドレス帯

I²Cの7ビットアドレス空間は0x08〜0x77が汎用領域（0x00〜0x07と0x78〜0x7Fは予約用途）。現在使用中のアドレスは以下の通り：

**使用中**：0x29、0x40、0x41、0x44、0x45、0x48、0x49、（0x70はAll Call、§3参照）

**空きアドレス帯**：
- 0x08〜0x28
- 0x2A〜0x3F
- 0x42〜0x43
- 0x46〜0x47
- 0x4A〜0x6F
- 0x71〜0x77（うち0x71／0x72／0x74はPCA9685のSub-callデフォルトのため、Sub-call有効化時は要注意。§3(c)参照）

新規I²Cデバイスを追加する場合、上記の空きアドレス帯から選定し、本書を更新すること。

## 5. 未決事項

- [ ] PCA9685 All Callの無効化コードの実装（`docs/OPEN_ISSUES.md` 登録済み）
- [ ] Sub-callアドレスを将来使用する場合の基板ごとの割当方針の事前決定

---

## 変更履歴

- **v1 2026-08-04** `docs/S/bench_axes_S3S4.md` から分離して新規作成。All Callアドレス重複の扱いと空きアドレス帯を明示した。
- **v1.1 2026-08-06** `docs/L/channel_map_L2.md` のリネームに伴い、本書内の相互参照を `docs/L/channel_map_L.md` へ更新した（内容の変更はない）。

## 参照一覧

| 資料 | URL | 取得日 |
|---|---|---|
| NXP PCA9685 データシート（MODE1レジスタ、ALLCALL/SUB1/SUB2/SUB3ビット、ALLCALLADR/SUBADRデフォルト値の根拠） | https://www.nxp.com/docs/en/data-sheet/PCA9685.pdf | 2026-08-04 |
| `docs/S/power_tree.md` | ローカルリポジトリ内 | 2026-08-04 |
| `docs/L/channel_map_L.md` | ローカルリポジトリ内 | 2026-08-04 |
| `docs/R/reserved_axes.md` | ローカルリポジトリ内 | 2026-08-04 |
| `docs/S/bench_axes_S3S4.md` | ローカルリポジトリ内 | 2026-08-04 |
| 旧文書 `docs/archive/2026-08-03_channel_map_hphase.md` | ローカルリポジトリ内 | 2026-08-03 |
