chinochino66/humanoid/media/README.md

# media

## 用途

部品写真・試験動画の保存先。

## 命名規則

`L2_部品名_YYYY-MM-DD.jpg` の形式とする。

## 撮影時の注意

ノギスを当てた状態で撮ると寸法証拠を兼ねられる。

## LFS対象

`.jpg` / `.jpeg` / `.mp4` / `.mov`
