chinochino66/humanoid/docs/S/safety_logic.md

# 頭部全体の固定安全ロジック

版数: v1.2
改訂日: 2026-08-06
準拠文書: 器創造計画 2026-2033（改訂基準日 2026-08-03）
系統タグ: S（安全・制御・知覚。頭部全体、L系・R系・S系すべてに適用）
変更履歴:
- v1 2026-08-04 `docs/S/bench_axes_S3S4.md` §6で「担当文書未確定」としていた、頭部全体に関わる固定安全ロジック（ベンチ限定でない8条件）を新規文書として分離。第3層未実装によるMega兼務のリスクを明記した。
- v1.1 2026-08-06 第3層に在庫のArduino Mega 2560の2枚目を充てることを決定した旨を反映（`docs/decisions/2026-08-06_layer3_controller_selection.md`）。ただし実配線・ファームウェア・動作検証は未着手であり、共倒れ構造は現時点で解消していないことを明記した。部品表の在庫状況（Mega 2560×2枚、予備ゼロ）を注記し、第3層が担う機能（実装予定・未着手）を列挙した。

**本書の位置づけ**：ベンチ限定の安全ロジック（漏水・トレー未装着・タンク満水・ポンプ連続駆動超過）は `docs/S/bench_axes_S3S4.md` §4を参照。本書は頭部全体（L系・R系・S系すべて）に適用される固定安全ロジックを扱う。**AI・LLMに安全判断を委ねない**（`docs/S/power_tree.md` §0 設計方針2）。

---

## 1. 固定安全ロジック（頭部全体、計8条件）

| # | 条件 | 検知手段 | 固定動作 | 担当層 |
|---|---|---|---|---|
| 1 | E-STOP押下 | 物理NC接点 | **アクチュエータ電源を物理遮断。**手動確認まで再始動禁止 | 第3層 |
| 2 | レール過電流 | INA219（0x44／0x45）が2A超×2秒 | 該当レールのサーボ停止 | 第2層→第3層 |
| 3 | 過熱 | 基板温度センサー（Megaピン A3、10kΩ NTCサーミスタ＋分圧抵抗10kΩ。2026-08-06決定・未入手） | 新規動作禁止 → 中立復帰 → 遮断 | 第3層 |
| 4 | 通信断（第1層） | 受信タイムアウト | **新規動作禁止。中立保持または力解放** | 第2層 |
| 5 | ハートビート停止（第2層） | 安全系ハートビート出力（Megaピン D10）のWDT | アクチュエータ電源遮断 | 第3層 |
| 6 | BMS低電圧 | BMS通知 | 新規動作禁止 → ログ保全 → 制御シャットダウン | 第3層 |
| 7 | モジュールID不明 | jawModuleID bit0/1（Megaピン D8/D9） | **顎駆動へ電力を供給しない** | 第3層 |
| 8 | 待機タイムアウト | ソフトタイマ | OE=HIGH（保持電流遮断）。復帰は OE=LOW→目標角 | 第2層 |

**#1と#5は電気的に第2層から独立していること。**Megaがハングしても働くこと。

**条件番号について**：旧文書 `docs/archive/2026-08-03_channel_map_hphase.md` §7の12条件のうち、ベンチ限定の4条件（漏水／トレー未装着／タンク満水／ポンプ連続駆動超過）は `docs/S/bench_axes_S3S4.md` §4へ移した。本書の8条件は残りの頭部全体条件であり、旧文書の番号とは対応しない（本書内で#1〜#8として振り直した）。

## 2. 第3層未実装の現状とリスク

**第3層（独立安全コントローラ）は、2026-08-06に在庫のArduino Mega 2560の2枚目を充てることを決定したが（`docs/decisions/2026-08-06_layer3_controller_selection.md`）、本書執筆時点では実配線・ファームウェアともに未実装である。**上表で「担当層：第3層」とした条件（#1、#3、#5、#6、#7）は、暫定的に**Arduino Mega（第2層）が兼務**している。

**部品表の在庫状況**：Arduino Mega 2560は部品表で在庫2枚。1枚目は第2層（頭部リアルタイム制御）に使用、2枚目を第3層（独立安全コントローラ）に充てる。予備はゼロとなる。

**第3層が担う機能（実装予定・未着手）**：以下は上表（§1）で担当層を「第3層」とした条件に対応する。いずれも実装予定であり、現時点では未着手。

- 第2層からのハートビート受信と途絶検知（上表#5に対応）
- 途絶・異常検知時の電力枝の遮断（上表#1・#3・#5・#6・#7に対応）
- 異常解除後、手動確認なしに再始動させないラッチ保持（上表#1に対応）
- 非常停止入力の受け付け（通信バスおよびAI OSから独立）（上表#1に対応）

**兼務のリスク**：上表#5「ハートビート停止（第2層）」は、本来Megaのハング自体を検知して独立した第3層が電源を遮断する設計である。しかし第3層が未実装でMegaが兼務している現状では、**Megaがハングした場合、ハートビート監視自体もMega上で動作しているため機能しない。**つまり、最も検知したい故障モード（Megaのハング）そのものが、検知機構を道連れにして機能停止する「共倒れ」構造になっている。2026-08-06、第3層に在庫のArduino Mega 2560の2枚目を充てることを決定した（`docs/decisions/2026-08-06_layer3_controller_selection.md`）。実配線・ファームウェア・動作検証はいずれも未着手であり、現時点では共倒れ構造が解消されたわけではない。

**#2「レール過電流」も同じ構造の共倒れ対象である。**INA219（0x44／0x45）はMegaのI²Cバス上にあり、Megaがハングすればバスのポーリング自体が止まるため、レール過電流の検知そのものが機能しなくなる。上表で担当層を「第2層→第3層」としているのはこの一次検知（第2層）から第3層への遮断委譲を表すが、第3層が未実装の現状では一次検知が止まった時点で経路全体が機能停止する。

同様に、E-STOP（#1）は物理NC接点による遮断のためMega非依存で成立しうるが、実際の遮断段（アクチュエータ遮断段）の制御ロジックが第3層ではなく第2層（Mega）に暫定実装されている場合、Megaのハング中はE-STOP押下後の遮断シーケンスが正しく実行されない可能性がある。**この配線・実装が第2層に依存していないか、実機で確認すること。**

→ 独立安全コントローラ（第3層）の選定は `docs/OPEN_ISSUES.md`（影響度：高）に登録済み。選定・実装までは、上記の共倒れリスクを許容した暫定運用であることを、運用者・オペレータへ明示すること。

## 3. 未決事項

- [ ] 独立安全コントローラ（第3層）の選定（`docs/OPEN_ISSUES.md` 登録済み）
- [ ] E-STOP遮断シーケンスが第2層（Mega）に依存していないか、実機配線の確認
- [ ] 過熱閾値（基板温度センサーA3）の具体的な数値の決定（素子は10kΩ NTCサーミスタで決定済み。閾値は未定）
- [ ] BMS低電圧の具体的な閾値電圧の決定（BMS型式未選定、`docs/S/power_tree.md` §7-2参照）

---

## 変更履歴

- **v1 2026-08-04** `docs/S/bench_axes_S3S4.md` から分離して新規作成。第3層未実装によるMega兼務の「共倒れ」リスクを明記した。
- **v1.1 2026-08-06** 第3層に在庫のArduino Mega 2560の2枚目を充てることを決定した旨を反映（`docs/decisions/2026-08-06_layer3_controller_selection.md`）。ただし実配線・ファームウェア・動作検証は未着手であり、共倒れ構造は現時点で解消していないことを明記した。部品表の在庫状況（Mega 2560×2枚、予備ゼロ）を注記し、第3層が担う機能（実装予定・未着手）を列挙した。
- **v1.2 2026-08-06** §1の#3（過熱）の検知手段欄へ、採用素子（10kΩ NTCサーミスタ＋分圧抵抗10kΩ、2026-08-06決定・未入手）を追記した。§3未決事項の過熱閾値の行へ、素子確定済み・閾値未定である旨を追記した。

## 参照一覧

| 資料 | URL | 取得日 |
|---|---|---|
| `docs/S/power_tree.md` | ローカルリポジトリ内 | 2026-08-04 |
| `docs/S/bench_axes_S3S4.md` | ローカルリポジトリ内 | 2026-08-04 |
| `docs/S/mcu_pinmap.md` | ローカルリポジトリ内 | 2026-08-04 |
| `docs/S/i2c_address_map.md` | ローカルリポジトリ内 | 2026-08-04 |
| 旧文書 `docs/archive/2026-08-03_channel_map_hphase.md` | ローカルリポジトリ内 | 2026-08-03 |
