chinochino66/humanoid/docs/decisions/2026-08-06_layer3_controller_selection.md

# 決定記録：第3層（独立安全コントローラ）に充てるマイコンの選定

版数: v1
改訂日: 2026-08-06
準拠文書: 器創造計画 2026-2033（改訂基準日 2026-08-03）
系統タグ: S（安全・制御・知覚。頭部第3層マイコンの選定）
変更履歴:
- v1 2026-08-06 新規作成

## 判断日

2026-08-06

## 決定

第3層（独立安全コントローラ）に、在庫のArduino Mega 2560の2枚目を充てる。

## 背景

`docs/S/safety_logic.md` は、現状では第2層（頭部リアルタイム制御）のArduino Mega 2560が制御と安全監視を兼務しており、第2層のMegaがハングした場合に安全監視機構も同時に機能停止する「共倒れ」構造であると自ら指摘している（`docs/OPEN_ISSUES.md` #1、影響度：高）。部品表にはArduino Mega 2560が2枚あり、1枚目は既に第2層で使用済みだが、2枚目は未使用である。この2枚目を第3層専任に充てることで、追加調達なしにこの構造的欠陥を解消できる。

## 選定理由

(1) 追加調達が不要である。部品表にArduino Mega 2560が2枚あり、1枚目が第2層で使用済み、2枚目が未使用である。

(2) 第2層と同一アーキテクチャのため、開発環境・書き込み手順・デバッグ手法を共用できる。

(3) `docs/OPEN_ISSUES.md` #1 は影響度「高」でありながら、解決に費用がかからない唯一の項目である。

## 却下した代替案とその理由

(a) 専用の安全コントローラICまたは産業用安全リレーの採用 … 調達費用と選定期間が発生する。L系学習機の段階では過剰である。将来R系の製品化時に再評価する。

(b) 単一Megaのままウォッチドッグタイマのみで対応 … Mega自身がハングした場合に同一チップ上のWDTだけでは外部の電力遮断まで到達できる保証がなく、共倒れ構造が残る。

## 本決定の限界

Arduino Mega 2560は機能安全規格（ISO 13849 / IEC 61508 等）の認証を受けた安全コントローラではない。本決定はL系学習機における暫定措置であり、R系商用頭部では認証済みデバイスの採用を含めて再評価する。手順書 S-Phase 0 の完了ゲート「非常停止が通信バスとAI OSから独立している」を満たすための構成であり、対人安全の認証を意味しない。

## 未実施事項

実配線、ファームウェア、ハートビート監視の実装、動作検証はすべて未着手。

## 参照一覧

- 器創造計画 2026-2033（改訂基準日 2026-08-03）
- `docs/S/safety_logic.md`
- `docs/OPEN_ISSUES.md` #1
- `docs/S/mcu_pinmap.md`
