chinochino66/humanoid/docs/R/reserved_axes.md

# R系予約軸表（2027年 R5-R9）

版数: v1.2
改訂日: 2026-08-06
準拠文書: 器創造計画 2026-2033（改訂基準日 2026-08-03）
系統タグ: R（独自商用頭部。白紙CADからの新規設計。2027年R1-R9）
変更履歴:
- v1 2026-08-04 旧H-Phase体系文書 `docs/archive/2026-08-03_channel_map_hphase.md` から、決定2に従いR系軸（表情7軸）を予約軸として新規分離。**InMoov由来の形状・寸法・メッシュへの参照は一切含めない。** 在庫MG92B×5・SG92R×8を2027年R系向けとして紐付けた。表情プリセット・顎モジュールモードを `docs/S/mcu_pinmap.md`・`docs/S/safety_logic.md` から軸名/モード名のみ申し送った（§4。具体値は書かない）。
  - forehead軸（foreheadRight／foreheadLeft）の綴り誤り（forhead→forehead）を修正。R系は白紙CADの新規設計であり、InMoov公式パーツ名の誤字を踏襲する理由がないため。
  - MG92B予備2個の配分方針を「S系ベンチ軸が別途調達を要する」という断定から、案(a)(b)の2案併記へ修正（§2・§5。`docs/S/bench_axes_S3S4.md` §1と整合）。
- **v1.1 2026-08-05** 部品表の「高荷重5軸（上唇・頬×2・喉ゲート・味覚リフト）→MG92B×5」が案(a)を前提としている事実を§2・§5に反映。正式採否は未確認のまま（`docs/OPEN_ISSUES.md` #13参照）。

**知財上の注意**：R系は白紙CADからの新規設計であり、L系（InMoov 100%学習機、Attribution-NonCommercial）の形状・寸法・STL・メッシュを一切引き継がない。本書は電気的な軸予約（チャンネル・在庫の紐付け）のみを扱い、寸法・形状・設計値は記載しない。詳細は `docs/decisions/2026-08-03_lrsm_migration.md` を参照。

---

## 1. 予約軸一覧（計7軸）

**2027年R5-R9で確定する。2026年は実装しない。**

| 軸名 | 予約CH（2026年は文書上のみ） | 系統 | 在庫紐付け | 状態 |
|---|---|---|---|---|
| upperLip | PCA9685 #1（0x40） ch0 | R | MG92B（在庫5個のうち割当予定） | 未実装。2027年R5で確定 |
| cheekRight | PCA9685 #1（0x40） ch1 | R | MG92B（同上） | 未実装。2027年R5で確定 |
| cheekLeft | PCA9685 #1（0x40） ch2 | R | MG92B（同上） | 未実装。2027年R5で確定 |
| eyebrowRight | PCA9685 #1（0x40） ch3 | R | SG92R（在庫8個のうち割当予定） | 未実装。2027年R5で確定 |
| eyebrowLeft | PCA9685 #1（0x40） ch4 | R | SG92R（同上） | 未実装。2027年R5で確定 |
| foreheadRight | PCA9685 #1（0x40） ch5 | R | SG92R（同上） | 未実装。2027年R5で確定 |
| foreheadLeft | PCA9685 #1（0x40） ch6 | R | SG92R（同上） | 未実装。2027年R5で確定 |

## 2. 在庫紐付け

| 型番 | 在庫数 | 対象軸数 | 紐付け | 用途外の使用禁止 |
|---|---|---|---|---|
| MG92B | 5個 | 3軸（upperLip／cheekRight／cheekLeft） | 3軸分＋予備2個。**2026-08-06に案(a)を正式採用（`docs/OPEN_ISSUES.md` #13 解決済み）。R系の予備は持たない。**`docs/S/bench_axes_S3S4.md` §1・`docs/OPEN_ISSUES.md` #13参照 | **2027年R系向け在庫。2026年に実装しない** |
| SG92R | 8個 | 4軸（eyebrowRight／eyebrowLeft／foreheadRight／foreheadLeft） | 4軸分＋予備4個 | **2027年R系向け在庫。2026年に実装しない** |

**在庫数の紐付けのみを行う。**寸法・形状・設計値・実装方法は本書に記載しない。型番の電気的仕様（電圧・トルク・電流等）は `docs/reference/servo_datasheets.md` を参照。

## 3. ボード・レールの物理分離について

決定2により、ボード・レールの物理分離は**2027年R5着手時**に行う。**2026年は文書上の分離のみとする。**

2026年時点では、上表の予約CHはPCA9685 #1（0x40）・レールA（5.8V）上の未接続チャンネルとして扱う。電力予算（`docs/S/power_tree.md` §6.1）にはこの7chの負荷を含めていない。物理的な配線・給電を2026年中に行わないこと。

## 4. 将来定義（表情プリセット・顎モジュールモード）

`docs/S/mcu_pinmap.md`・`docs/S/safety_logic.md` からの申し送り。**軸名・モード名のみを記載し、具体的な角度・パルス幅・プリセット値は書かない**（旧文書の数値はInMoov由来の可能性があり、R系文書に持ち込まない）。

**表情プリセット**（対象：本書§1のR系表情軸。2027年R5以降に具体値を定義）：
`neutral` ／ `angry` ／ `suspicious` ／ `thin_smile` ／ `taste_dislike` ／ `taste_approve`

**顎モジュールモード**（jawModuleID、`docs/S/mcu_pinmap.md` §2 D8/D9参照。2027年以降に具体的な制限値を定義）：
`EXPRESSION_JAW` ／ `TASTE_ONLY` ／ `MASTICATION_BENCH` ／ `MASTICATION_INSTALLED`

## 5. 未決事項

- [ ] 2027年R5着手時のボード・レール物理分離方式の決定
- [ ] R系独自頭部の白紙CAD設計着手（本書の対象外。R5以降の別文書で扱う）
- 【2026-08-06 解決】MG92B予備2個の配分は案(a)で確定
- [ ] 表情プリセット・顎モジュールモードの具体値（角度・パルス幅）の定義（2027年R5以降）

---

## 変更履歴

- **v1 2026-08-04** 旧H-Phase体系文書からR系予約軸のみを分離して新規作成。InMoov由来の形状・寸法・メッシュへの参照を一切含めない方針で作成。
- **v1.2 2026-08-06** MG92B予備2個の配分方針を案(a)で正式採用（`docs/OPEN_ISSUES.md` #13 解決済み）。§2の「正式採否は未確認」の記述を「2026-08-06に案(a)を正式採用。R系の予備は持たない」へ更新し、§5の未決事項からMG92B配分の行を「【2026-08-06 解決】MG92B予備2個の配分は案(a)で確定」へ置き換えた。

## 参照一覧

| 資料 | URL | 取得日 |
|---|---|---|
| `docs/decisions/2026-08-03_lrsm_migration.md` | ローカルリポジトリ内 | 2026-08-04 |
| `docs/reference/servo_datasheets.md` | ローカルリポジトリ内 | 2026-08-04 |
| `docs/S/power_tree.md` | ローカルリポジトリ内 | 2026-08-04 |
| 旧文書 `docs/archive/2026-08-03_channel_map_hphase.md` | ローカルリポジトリ内 | 2026-08-03 |
