chinochino66/humanoid/docs/archive/README.md

# archive

旧H-Phase体系（改訂手順書 H-Phase 0-24 以前）の文書を退避する場所。

現行の文書構成に統合・置き換えられたため、参照専用として残している。新規の設計判断はここではなく最新のドキュメントを参照すること。

| ファイル | 旧名 | 退避理由 |
|---|---|---|
| [2026-08-03_channel_map_hphase.md](2026-08-03_channel_map_hphase.md) | `channel_map.md` | 旧H-Phase体系のため |
| [2026-08-03_power_system_hphase.md](2026-08-03_power_system_hphase.md) | `power_system.md` | 旧H-Phase体系のため |
| [2026-08-03_servo_comparison_hphase.md](2026-08-03_servo_comparison_hphase.md) | `servo_comparison.md` | 旧H-Phase体系のため |
