chinochino66/humanoid/(list of files, cad)

Other CAD files:
cad/L2_SkullServoFixV5_100pct_HHE+0.3_2026-08-06.3mf
