chinochino66/humanoid/docs/L/print_record_L.md

# 印刷部品台帳

版数: v1.4
改訂日: 2026-08-11
準拠文書: 器創造計画 2026-2033（改訂基準日 2026-08-03）
系統タグ: L
変更履歴:
- v1 2026-08-06 新規作成。手順書のL完了ゲート「全公式部品について100%スケールの記録がある」を満たすための台帳として、部品台帳・実測記録の様式を整備した。
- v1.1 2026-08-06 §3実測記録にNeckServoHolderV2（サーボポケット長辺・短辺・角部高さ）とSkullServoFixV5（M3ネジ穴貫通確認）の実測4件を追加。印刷収縮率-1.0%（内寸方向）を確定し、対策案（Horizontal Expansion -0.15／耐水ペーパー削り）を記録した（`docs/OPEN_ISSUES.md` #12）。
- v1.2 2026-08-06 §2の印刷状態が全行「未印刷」のままで§3の実測記録と矛盾していたため訂正。L-Phase 2・3の全14行（MainGearV2／ServoGearV2／RingV2／GearHolderV3／NeckPlateHighV2／NeckPlateV2／SkullServoFixV5／NeckV3／NeckJointLowerV5／NeckServoHolderV2／NeckServoPivotV2／NeckBoltsV2／ThroatHolderV2／ThroatHoleV3）の印刷状態を「印刷済み（時期不明）」、スケール記録の有無を「なし（事後取得不可。§3の実測で代替）」に変更した。NeckServoHolderV2とSkullServoFixV5の実測列に§3への参照を追記した。L-Phase 4・5の16行は変更していない。§2冒頭に注記を追加した。
- v1.3 2026-08-06 §3実測記録の2026-08-06付3行（サーボポケット長辺・短辺・角部高さ）の部品名を、記録時の取り違えによりNeckServoHolderV2からSkullServoFixV5へ訂正した。§2部品台帳のSkullServoFixV5の実測列を「あり（§3、ポケット内寸＋M3貫通確認）」へ、NeckServoHolderV2の実測列を「未実測」へ訂正した。§3「-0.3mmへの対策」の再印刷対象をSkullServoFixV5へ訂正した。§5未決事項にNeckServoHolderV2のポケット内寸STL確認を追加した（`docs/OPEN_ISSUES.md` #12・#39）。
- v1.4 2026-08-11 Cura の Hole Horizontal Expansion +0.3mm によりSkullServoFixV5を再印刷し、ポケット短辺30.1mmを実測した（§3）。実測変化量が設定値の約2倍（+0.8mm）であった知見を記録した。§2部品台帳のSkullServoFixV5の行を再印刷済みへ更新し、3MF・gcodeの保存先を記入した。再印刷条件の小見出しを追加した。§5未決事項2件を更新した。

---

## 1. 本書の目的

手順書のL完了ゲート「全公式部品について100%スケールの記録がある」を満たすための台帳である。

印刷済み部品については、スライサー画面の記録が事後に取得できないため、以下の3種の証拠を代替として用いる方針とする：

- (a) 実測値（ノギス）とSTL設計値の突き合わせ ← 最も強い証拠。出力結果そのものを示す
- (b) gcodeファイル末尾に残るスライサー設定ブロック（倍率・層高・Horizontal Expansion・材料）
- (c) 部品の写真

未印刷の部品については、印刷時に3MFを保存し、スライサー画面のスクリーンショットを取得する。

## 2. 部品台帳

**注記（2026-08-06）**

L-Phase 2・3 の部品は既に印刷済みである。ただし印刷時のスライサー画面・3MF・gcodeを
保存する運用が確立されていなかったため、スケール設定の直接的な記録が存在しない。
§1(a) の方針に従い、実測値とSTL設計値の突き合わせをスケール証拠として用いる。
gcodeが後から発見された場合は §5 の未決事項に従って追加する。

| 部品名 | 対応Phase | 印刷状態 | スケール記録の有無 | 3MF | gcode | 写真 | 実測 | 備考 |
|---|---|---|---|---|---|---|---|---|
| MainGearV2 | L-Phase 2 | 印刷済み（時期不明） | なし（事後取得不可。§3の実測で代替） | 未記入 | 未記入 | 未記入 | 未記入 | |
| ServoGearV2 | L-Phase 2 | 印刷済み（時期不明） | なし（事後取得不可。§3の実測で代替） | 未記入 | 未記入 | 未記入 | 未記入 | |
| RingV2 | L-Phase 2 | 印刷済み（時期不明） | なし（事後取得不可。§3の実測で代替） | 未記入 | 未記入 | 未記入 | 未記入 | |
| GearHolderV3 | L-Phase 2 | 印刷済み（時期不明） | なし（事後取得不可。§3の実測で代替） | 未記入 | 未記入 | 未記入 | 未記入 | |
| NeckPlateHighV2 | L-Phase 2 | 印刷済み（時期不明） | なし（事後取得不可。§3の実測で代替） | 未記入 | 未記入 | 未記入 | 未記入 | |
| NeckPlateV2 | L-Phase 2 | 印刷済み（時期不明） | なし（事後取得不可。§3の実測で代替） | 未記入 | 未記入 | 未記入 | 未記入 | |
| SkullServoFixV5 | L-Phase 2 | 再印刷済み（2026-08-11） | あり（3MF・gcode・スライサー設定を保存） | `cad/L2_SkullServoFixV5_100pct_HHE+0.3_2026-08-06.3mf` | `cad/L2_SkullServoFixV5_100pct_HHE03_2026-08-06.gcode` | 未記入 | あり（§3、再印刷後30.1mm） | |
| NeckV3 | L-Phase 3 | 印刷済み（時期不明） | なし（事後取得不可。§3の実測で代替） | 未記入 | 未記入 | 未記入 | 未記入 | |
| NeckJointLowerV5 | L-Phase 3 | 印刷済み（時期不明） | なし（事後取得不可。§3の実測で代替） | 未記入 | 未記入 | 未記入 | 未記入 | |
| NeckServoHolderV2 | L-Phase 3 | 印刷済み（時期不明） | なし（事後取得不可。§3の実測で代替） | 未記入 | 未記入 | 未記入 | 未実測 | |
| NeckServoPivotV2 | L-Phase 3 | 印刷済み（時期不明） | なし（事後取得不可。§3の実測で代替） | 未記入 | 未記入 | 未記入 | 未記入 | |
| NeckBoltsV2 | L-Phase 3 | 印刷済み（時期不明） | なし（事後取得不可。§3の実測で代替） | 未記入 | 未記入 | 未記入 | 未記入 | |
| ThroatHolderV2 | L-Phase 3 | 印刷済み（時期不明） | なし（事後取得不可。§3の実測で代替） | 未記入 | 未記入 | 未記入 | 未記入 | |
| ThroatHoleV3 | L-Phase 3 | 印刷済み（時期不明） | なし（事後取得不可。§3の実測で代替） | 未記入 | 未記入 | 未記入 | 未記入 | |
| FaceHolderLeftV5 | L-Phase 4 | 未印刷 | 未記入 | 未記入 | 未記入 | 未記入 | 未記入 | |
| FaceHolderRightV5 | L-Phase 4 | 未印刷 | 未記入 | 未記入 | 未記入 | 未記入 | 未記入 | |
| LowBackV5 | L-Phase 4 | 未印刷 | 未記入 | 未記入 | 未記入 | 未記入 | 未記入 | |
| TopBackskullV4 | L-Phase 4 | 未印刷 | 未記入 | 未記入 | 未記入 | 未記入 | 未記入 | |
| TopskullV5 | L-Phase 4 | 未印刷 | 未記入 | 未記入 | 未記入 | 未記入 | 未記入 | |
| TopskullFrontV1 | L-Phase 4 | 未印刷 | 未記入 | 未記入 | 未記入 | 未記入 | 未記入 | |
| EarLockV1 | L-Phase 4 | 未印刷 | 未記入 | 未記入 | 未記入 | 未記入 | 未記入 | |
| ForHeadSupportV2 | L-Phase 4 | 未印刷 | 未記入 | 未記入 | 未記入 | 未記入 | 未記入 | |
| JawHingeV4 | L-Phase 5 | 未印刷 | 未記入 | 未記入 | 未記入 | 未記入 | 未記入 | |
| JawPistonV1NoSupport | L-Phase 5 | 未印刷 | 未記入 | 未記入 | 未記入 | 未記入 | 未記入 | |
| JawSupportV2 | L-Phase 5 | 未印刷 | 未記入 | 未記入 | 未記入 | 未記入 | 未記入 | |
| JawV5 | L-Phase 5 | 未印刷 | 未記入 | 未記入 | 未記入 | 未記入 | 未記入 | |
| BottomTeethV1 | L-Phase 5 | 未印刷 | 未記入 | 未記入 | 未記入 | 未記入 | 未記入 | |
| TopTeethV3 | L-Phase 5 | 未印刷 | 未記入 | 未記入 | 未記入 | 未記入 | 未記入 | |
| TeethTopHolderV3 | L-Phase 5 | 未印刷 | 未記入 | 未記入 | 未記入 | 未記入 | 未記入 | |
| UpperLipV2 | L-Phase 5 | 未印刷 | 未記入 | 未記入 | 未記入 | 未記入 | 未記入 | |

#### SkullServoFixV5 再印刷の条件（2026-08-11）

| 項目 | 値 |
|---|---|
| プリンタ | ELEGOO NEPTUNE 4 Plus |
| ノズル | 0.40mm |
| 材料 | Generic PLA |
| プロファイル | Fast #2（層高 0.2mm） |
| スケール | X/Y/Z すべて 100.0% |
| Wall Line Count | 7（≒2.8mm。公式指定2.5mmを上回る側に設定） |
| インフィル | 30% |
| Hole Horizontal Expansion | **+0.3mm** |
| Horizontal Expansion | 0.0mm |
| サポート | なし |
| 所要時間 | 5時間47分 |
| フィラメント使用量 | 64g / 21.53m |

Wall Line Count を 7 とした理由：Cura のプロファイル側で Wall Line Count が
手動指定されており Wall Thickness が無効化されていたため、直接指定した。
ノズル 0.40mm × 7 = 2.8mm。公式 Neck and Jaw チュートリアルの指定は 2.5mm、
i2Head チュートリアルの指定は 2.0mm であるが、
本部品は HS-805BB（153g）を頭蓋へ固定する構造部品であり首の全荷重が通るため、
厚い側へ倒した。

## 3. 実測記録

| 測定日 | 部品名 | 測定箇所 | 設計値(mm) | 実測値(mm) | 差(mm) | 測定器 | 備考 |
|---|---|---|---|---|---|---|---|
| 2026-08-06 | SkullServoFixV5 | サーボポケット長辺（内寸） | 65.6 | 65.7 | +0.1 | デジタルノギス | HS-805BB実寸との比較。【2026-08-06訂正】当初NeckServoHolderV2として記録したが誤り |
| 2026-08-06 | SkullServoFixV5 | サーボポケット短辺（内寸） | 29.6 | 29.3 | -0.3 | デジタルノギス | 約-1.0%。要対策。【2026-08-06訂正】当初NeckServoHolderV2として記録したが誤り |
| 2026-08-06 | SkullServoFixV5 | 角部高さ | 未確認 | 8.2 | - | デジタルノギス | 設計値未取得。【2026-08-06訂正】当初NeckServoHolderV2として記録したが誤り |
| 2026-08-06 | SkullServoFixV5 | M3ネジ穴の貫通確認 | - | 可 | - | M3×16実物 | 公式指定は木ネジ4本。M3も通る |
| 2026-08-11 | SkullServoFixV5（再印刷） | サーボポケット短辺（内寸） | 29.6 | 30.1 | +0.5 | デジタルノギス | Hole Horizontal Expansion +0.3 適用後。HS-805BB収容可 |

**確定した印刷収縮率**

サーボポケット短辺で設計値29.6mmに対し実測29.3mm、差-0.3mm（約-1.0%）。
これが本機（Elegoo Neptune 4 Plus／PLA）における内寸（穴・ポケット）方向の収縮量である。
CALIBRATORによる校正の目的（印刷公差の把握）は、本測定により実部品上で達成された。
他部品の網羅的な寸法測定は不要とし、嵌合の可否は仮組みで判定する。

**-0.3mmへの対策（2026-08-11 実施・完了）**

InMoov公式チュートリアルは、部品同士が嵌まりにくい場合の対処として
スライサーのHorizontal Expansionを-0.15から始めることを推奨している。
-0.15を設定すると内寸は左右それぞれ0.15mm拡大し合計+0.3mmとなり、本件の不足量と一致する。
対策案は以下の2つ。採否は未決（`docs/OPEN_ISSUES.md` #12 を参照）。

 (a) Horizontal Expansion -0.15 で SkullServoFixV5 を再印刷する。
     設定が他部品にも継続適用できるため推奨。

 (b) 耐水ペーパー#400（在庫あり）でポケット内側を片側0.15mm削る。即時実施可能だが部品ごとの手作業となる。

**実施結果（2026-08-11）**

対策(a)を実施した。Cura の **Hole Horizontal Expansion を +0.3mm** に設定し
（Horizontal Expansion は 0.0 のまま）、SkullServoFixV5 を再印刷した。
ポケット短辺は 29.3mm → **30.1mm** となり、HS-805BB の実寸 29.6mm に対し
0.5mm の余裕をもって収容可能となった。

**重要な知見：設定値と実効値が一致しない**

設定は +0.3mm だが、実測変化量は **+0.8mm** であった。
Cura の Hole Horizontal Expansion は穴の輪郭を法線方向へオフセットする設定であり、
対向する2面がそれぞれ広がるため、**内寸としては設定値の約2倍が加算される**と解される
（+0.3 × 2 = +0.6mm。実測との差 0.2mm は測定誤差およびバリ除去分と推定）。
次回同種の補正を行う際は、**目標とする内寸増加量の半分を設定値とすること**。
本件では余裕をもって収まったため再印刷は行わないが、
今後は +0.15mm 程度が適切と考えられる。

最優先で測定すべき2件：

- NeckServoHolderV2 のサーボ取付穴 … HS-805BB（66×30×57.6mm）が入るかの確認。首サーボ発注の前提（docs/OPEN_ISSUES.md #12）
- SkullServoFixV5 のサーボ取付穴 … 同上

## 4. 混在部品の扱い

100%と94%の混在部品の扱いは `docs/L/failure_log/scale_94.md` §5 の運用規則を参照する。

## 5. 未決事項

- [ ] 印刷済み部品のgcode／3MFの所在確認（SDカード・USB・PC出力フォルダ・スライサーの最近のプロジェクト）（SkullServoFixV5 のみ2026-08-11に3MF・gcodeを保存済み。他部品は依然として未取得）
- [x] NeckServoHolderV2／SkullServoFixV5 の実測（#12）。2026-08-06実施、結果は§3参照。ただし-0.3mmの対策は未実施のため#12自体は継続
- [ ] 未印刷部品の印刷時に3MFとスクリーンショットを取得する運用の徹底
- [ ] **NeckServoHolderV2 のサーボポケット内寸をSTL上で確認する**（設計値。載るサーボの特定に必要。`docs/OPEN_ISSUES.md` #39）
