chinochino66/humanoid/docs/OPEN_ISSUES.md

# 未確認事項一覧

版数: v1.21
改訂日: 2026-08-11
準拠文書: 器創造計画 2026-2033（改訂基準日 2026-08-03）
系統タグ: 系統非依存（全系統の未確認事項を横断的に管理する）
変更履歴:
- v1 2026-08-04 L/R/S/M体系への移行に伴い新規作成。各文書中で「`docs/OPEN_ISSUES.md` へ登録」とした項目を、影響度別に一覧化した。

**本書の位置づけ**：各文書（`docs/S/power_tree.md`・`docs/L/servo_assignment_L.md`・`docs/reference/servo_datasheets.md`・`docs/L/channel_map_L.md`・`docs/R/reserved_axes.md`・`docs/S/bench_axes_S3S4.md`・`docs/S/i2c_address_map.md`・`docs/S/safety_logic.md`・`docs/S/mcu_pinmap.md`・`docs/L/failure_log/scale_94.md`・`docs/README.md`）で「未確認」「未実測」「未決定」として登録された事項を、影響度別に横断管理する。解決したら該当行を消さず、現状・期限を更新し、解決日を付記すること。

---

## 影響度：高

| # | 項目 | 影響度 | 現状 | 確認方法 | 期限 | 解決時に更新する文書 |
|---|---|---|---|---|---|---|
| 1 | 独立安全コントローラ（第3層）の選定 | 高 | 未選定。現状Arduino Mega（第2層）が兼務しており、Megaがハングすると安全系も同時に機能停止する「共倒れ」構造。2026-08-06、第3層に在庫のArduino Mega 2560の2枚目を充てることを決定した（`docs/decisions/2026-08-06_layer3_controller_selection.md`）。追加調達は不要。ただし実配線・ファームウェア・ハートビート監視の実装・動作検証はすべて未着手であり、**共倒れ構造は現時点では解消していない。** 本項目は未解決のまま継続する。 | 候補マイコンの比較・要件定義（AI/OS/通信バスから独立、E-STOP・漏水・過電流・過熱・WDT・電源遮断を担当できること）。第3層Megaを実配線し、第2層Megaを強制的にハングさせた状態で電力遮断が動作することを実機で確認する。 | 未定 | `docs/S/safety_logic.md`、`docs/S/mcu_pinmap.md`、`docs/S/power_tree.md`、`docs/decisions/2026-08-06_layer3_controller_selection.md` |
| 2 | 頭部質量・重心の実測 | 高 | 未実施 | 頭部印刷完了後、L3でトルク検証と併せて実測 | 印刷完了後（L3） | `docs/L/servo_assignment_L.md` |
| 3 | 12V母線の逆接保護 | 高 | 未解決。候補2案（理想ダイオードコントローラ／ショットキーダイオード）を提示済みだが未実装。2026-08-06、案1（理想ダイオードコントローラ＋NチャネルMOSFET）を正式採用した（`docs/S/power_tree.md` §7-4）。案2のショットキー方式は定常0.3〜0.6Wの常時発熱を頭部内に持ち込むため却下した。具体的な型番は未確定、部品は未入手、実装は未着手。同日中に方式を再検討し、**PチャネルMOSFET方式（2SJ334＋ツェナー＋ゲート抵抗100kΩ）へ変更した**。理想ダイオードIC案はSMDパッケージで専用基板を要し、秋月電子に取扱いがないため撤回した。2SJ334とツェナーダイオードは2026-08-06に調達済み。ゲート抵抗は在庫から充当する。なお12V母線のTVSがSMBJ18CA（クランプ約29V）であり、PchMOSFETのゲート-ソース間定格20Vを超えるため、ゲート保護ツェナーが必須である。**部品は入手したが実装・検証は未着手であり、逆接保護は現時点で機能していない。** | いずれかの方式を選定し実装。損失・発熱を評価。入手性を確認して型番を確定し、実装後に順方向電圧降下と発熱を実測する。2SJ334のRds(on)をデータシートで確認し、実装後に順方向電圧降下・発熱・逆接続時の遮断を実測する。ゲート-ソース間電圧がツェナーで20V以下にクランプされることを確認する。 | 12V母線の実配線前 | `docs/S/power_tree.md` |
| 4 | E-STOP後の残留エネルギー放電経路 | 高 | 専用の放電（ブリーダ）抵抗が無い設計不備を確認済み。放電時間が接続負荷次第で数ms〜不定。2026-08-06、対策としてレールA・Bの各2200µFへ10kΩ / 1/4W のブリーダ抵抗を1本ずつ並列接続する設計値を決定した（`docs/S/power_tree.md` §7-3）。時定数22ms、無負荷でも110msで約99%放電する。抵抗は在庫の抵抗セットから充当でき追加調達は不要。**未実装であり、設計不備は現時点では解消していない。** | 放電抵抗の追加要否を検討し、追加する場合は定数を計算・実装。実装後、無負荷状態でのE-STOP後の実測放電時間を記録する | 未定 | `docs/S/power_tree.md` |
| 5 | E-STOP遮断シーケンスが第2層（Mega）に依存していないか | 高 | 未確認。依存している場合、Megaのハング中にE-STOP押下後の遮断が正しく実行されない可能性 | 実機配線・回路図の確認 | 未定 | `docs/S/safety_logic.md` |
| 6 | 首サーボ（HS-805BB×2）の5V時トルク実測 | 高 | 線形補間値（約20.6kg·cm）のみで、選定条件（20kg·cm以上）を僅差で満たす判定。実測ではない。2026-08-06時点の方針: L系は公式InMoov部品を100%スケールで印刷する学習機であり、形状・質量が公式と同一になるため、公式指定HS-805BBの採用根拠は成立している（決定1）。5V運用時のトルク余裕の検証は、頭部質量の実測（#2）と併せてL3のトルク検証で行う。本項目の未解決を理由にHS-805BBの発注を保留しない。 | 発注前に実機トルク計測、または5.0V時の値をメーカーへ確認 | 首サーボ発注前 | `docs/L/servo_assignment_L.md` |
| 30 | 【解決済み・2026-08-04】目の軸数・型番の確認 | 高 | `inmoov.fr/eyes-i2/`（取得日2026-08-04）の一次情報により確定。**目は眼球4軸＋瞼4軸＝計8軸（左右独立、ソフトウェア同期）、公式指定サーボはJX PDI-1109MG。**旧「eyeX/eyeY共通2軸＋瞼2軸（MG90S）」は誤りだった。`docs/L/channel_map_L.md`・`docs/L/servo_assignment_L.md`・`docs/S/power_tree.md` §6.1を再計算済み。経緯は `docs/decisions/2026-08-04_eye_axis_count_correction.md` を参照 | 解決済み（軸数・型番の確定）。残る作業は#31〜#33を参照 | 解決日: 2026-08-04 | `docs/L/channel_map_L.md`、`docs/L/servo_assignment_L.md`、`docs/S/power_tree.md` §6.1 |
| 31 | 目サーボ4本の追加調達（MG90S×4では8軸に不足） | 高 | 目・瞼は8軸確定（#30）。在庫MG90S×4本では4軸分しか賄えず、残り4軸分が不足する。公式指定JX PDI-1109MGを新規発注する場合は8本、在庫MG90Sを併用する場合は追加4本の発注が必要。2026-08-06、公式部品リストにより瞼4軸もJX PDI-1109MGで確定（#33解決）。目8軸すべてを1109MGで統一する。公式頭部全体では1109MG×15本が指定されている。 | 発注方針（JX PDI-1109MG統一かMG90S併用か）を決定し、必要数を発注する | L4実装前（手順書のL-Phase 2は首回転のみ。目はL-Phase 4） | `docs/L/servo_assignment_L.md` §2.1、`docs/L/channel_map_L.md` §1 |
| 38 | L0/L1成果物7件がリポジトリ未収録 | 高 | 手順書はL0・L1を完了済みとするが、成果物（Muzan_L0_WetSystem_Layout_COMPLETE_v1.blend／L0_WetDry_ServiceRoute_Map_v1／Phase0_Handover_Record_v1／Calibrator_Result_v1／ServoCenter.ino／servo_pin_map.csv／L1_clearance_check.md）がリポジトリに1件も存在しない。手順書のL-Phase 2開始条件が「Calibrator_Result_v1 の採用値がある」であるため、L2の開始条件を文書上満たせていない。#28（CALIBRATOR比較の詳細記録の所在確認）と同根の問題。2026-08-06、ServoCenter.ino と servo_pin_map.csv を現行設計（PCA9685×2構成）に合わせて再作成し firmware/ へ収録した。ただしこれらはL1当時の原本ではなく実機未検証であるため、L-Phase 1 の完了記録としない。本項目は未解決のまま継続する。残る未収録: Muzan_L0_WetSystem_Layout_COMPLETE_v1.blend／L0_WetDry_ServiceRoute_Map_v1／Phase0_Handover_Record_v1／Calibrator_Result_v1（#28で記録なしを確定）／L1_clearance_check.md | ローカル環境で7件の所在を確認し、存在するものをコミットする。存在しないものは「記録なし」を確定させ、再取得の要否を判断する | L2完了ゲート前 | `docs/README.md`、`docs/L/failure_log/scale_94.md` |
| 11 | 顎サーボの選定（公式指定 JX PDI-6221MG） | 高 | 2026-08-06、公式i2Headチュートリアルの精読により、顎サーボの公式指定が**JX PDI-6221MG（180°）**であることが判明した。旧項目名は「jaw候補（MG996R／DS3218MG）の最終決定」であり、DS3218MGが5V時トルクの観点で有力とされていたが、これらは公式指定ではないため候補から外し選定をやり直す。L系は公式部品を100%スケールで印刷する学習機であり、JawPistonのサーボ取付穴が6221MG前提で設計されている可能性が高い。**まずJawPistonV1NoSupportのSTL上の取付穴ピッチと、6221MGの取付穴ピッチを照合すること。**6221MGの5V時トルク・速度は未確認（`docs/reference/servo_datasheets.md`）。なお旧Neck and Jawチュートリアルは顎にHK15298を指定しているが、これは旧ヘッド用でありi2Headでは6221MGに変更されている。2026-08-06、JX PDI-6221MGを1個調達した。トルク値も判明した（4.8Vで17.25 kg·cm、6.0Vで20.32 kg·cm、5.0V線形補間で約17.8 kg·cm。`docs/reference/servo_datasheets.md`）。ただし出典は販売店の商品説明でありメーカー公式データシートによる確認は未実施。また本製品には120°／180°／360°の別モデルが存在し、公式指定は180°であるが、**現物が180°版であるかの確認は未実施**である。JawPistonのSTL取付穴ピッチの事前照合は不要と判断した。公式が同一チュートリアル内でJawPistonと6221MGを組み合わせて指定しており、公式STLを100%スケールで印刷する以上、寸法整合は設計上の前提であるため。嵌合の可否はL-Phase 5で印刷後に実機で確認する。2026-08-06、InMoov公式 Hardware and BOM ページ（https://inmoov.fr/default-hardware-map/、取得日2026-08-06）で「1x servos HK15298B JAW MECHANISM」と記載されていることを確認した。同ページのコメント欄における設計者Gael Langevinの回答（2018-12-30）は「For the jaw you need one HK15298B or some (PDI-6221MG, make sure to get 180°)」としており、**JX PDI-6221MG（180°）は公式に認められた代替である**ことが確定した。調達済みの6221MGを顎に使用する方針で確定とするが、**現物が180°版であるかの確認は未実施**である。設計者は明示的に「make sure to get 180°」と注意を promptしており、確認は必須である。 | 現物到着後に動作角が180°版であることを確認する。L-Phase 5でJawPistonを Hole Horizontal Expansion +0.3 で印刷し、実機で嵌合を確認する。 | L3 | `docs/L/servo_assignment_L.md`、`firmware/servo_pin_map.csv` |

## 影響度：中

| # | 項目 | 影響度 | 現状 | 確認方法 | 期限 | 解決時に更新する文書 |
|---|---|---|---|---|---|---|
| 7 | PCA9685のAll Callアドレス2枚重複の扱い | 中 | **実装済み・実機未検証。**2026-08-06、firmware/ServoCenter.ino の setup() 内で両基板のMODE1レジスタALLCALLビットを0に書き込む処理を実装した（disableAllCall関数）。ただし実機での動作確認は未実施であり、無効化の成否は未検証。ServoCenter.ino は起動時に無効化の成否をシリアルへ出力し、i コマンドのI2Cスキャンで0x70が応答しないことを確認できる。 | 実機でServoCenter.inoを起動し、iコマンドのI2Cスキャンで0x70が検出されないことを確認する | 未定 | `docs/S/i2c_address_map.md`、`firmware/ServoCenter.ino` |
| 8 | プリチャージ回路の実装方式・BMS型式・主電源SWのinrush定格確認 | 中 | 「未使用」から「使用する」方針へ変更したが、回路（案a/案b）・BMS型式・主電源SWの定格のいずれも未確定・未実測。2026-08-11、実装方式を決定した。在庫の12V 20Aミニロッカースイッチ2個による2段階投入方式を採用する（`docs/S/power_tree.md` §7-2）。追加調達は不要。リレーによるバイパス方式は、コイル電源とタイマー回路が必要となり電源投入シーケンスが能動回路に依存するため却下した。**未実装であり、突入電流の問題は現時点では解消していない。**また本方式は人間の操作順序に依存するため、SW2をONのままSW1を投入した場合のリスクは構造的に残存する。 | BMS型式選定後にOCP/SCP閾値・応答時間を確認、主電源SWのデータシートでinrush/make定格を確認、プリチャージ回路を実装・実測。実装後、SW1投入から母線電圧が定常値に達するまでの時間を実測する。 | 電源系実装前 | `docs/S/power_tree.md` |
| 9 | PTCの保護協調の整理 | 中 | 未整理。**目の8軸化により、レールAの理論上限電流（8軸同時ストール）が2.8A→5.6Aとなり、PTCのトリップ電流5.0Aを初めて上回った**（4ch想定時はトリップ電流を下回っておりPTCはそもそもトリップし得なかった）。ただしトリップ時間は最大故障電流でも最大15.6秒であり、LM2596の破壊域に対してあまりに遅いため、**「PTCはレギュレータ自体を保護しない」という結論は不変**（`docs/S/power_tree.md` §7-5(a)）。トリップ電流がレギュレータ実用電流を上回る、高温側で保持電流が低下する等、残る3点も未解決のまま | 頭部内想定周囲温度を定義し実効保持電流を再計算。電圧降下を各レール予算へ算入 | 未定 | `docs/S/power_tree.md` |
| 10 | レールAの同時ストール軸数制限（最大2軸まで）のソフト実装・実測 | 中 | 未実装。8軸同時ストールの理論上限（5.6A）はLM2596の実用2A枠を約2.8倍超える。旧記載「4軸／2.8A」は目の軸数訂正（#30）が未反映だったため2026-08-06に修正（#9・`docs/S/power_tree.md` §6.1 と一致させた） | ファームウェアで同時駆動数を制限し、実測で検証 | 未定 | `docs/S/power_tree.md`、`docs/L/channel_map_L.md` |
| 12 | 【解決済み・2026-08-11】NeckServoHolderV2／SkullServoFixV5の実寸とサーボ外形の照合 | 中 | 2026-08-06にSkullServoFixV5のサーボポケットを実測。長辺65.7mm（HS-805BB実寸65.6mmに対し+0.1mm）、短辺29.3mm（同29.6mmに対し-0.3mm）。長辺は問題なし。短辺が0.3mm不足しており、このままでは嵌合しない。公式推奨のHorizontal Expansion -0.15（内寸+0.3mm相当）で解消する見込みだが、対策は未実施。SkullServoFixV5はM3×16の貫通を実物で確認済み（公式指定は木ネジ4本）。**照合作業は完了したが、-0.3mmの対策が未実施のため本項目は解決としない。** **【2026-08-06 訂正】** 上記の実測値は当初 NeckServoHolderV2 のものとして記録したが、実際に測定した部品は **SkullServoFixV5** であった。部品名の取り違えである。SkullServoFixV5 は公式i2Headチュートリアルで HS-805BB を固定する部品として明記されており、実測値とHS-805BB実寸の一致は**首回転軸**の裏付けとして有効である。**NeckServoHolderV2 は未実測のままである。** **【2026-08-11 解決】** Cura の Hole Horizontal Expansion を +0.3mm に設定して SkullServoFixV5 を再印刷し、ポケット短辺 **30.1mm** を実測で確認した。HS-805BB の実寸 29.6mm に対し 0.5mm の余裕があり、収容可能である。なお設定値 +0.3mm に対し実測変化量は +0.8mm であり、Cura の同設定は内寸に対して設定値の約2倍が加算されると解される。詳細は `docs/L/print_record_L.md` §3 を参照。NeckServoHolderV2 は依然として未実測だが、公式BOMによりサーボが確定しているため実測の必要性は低い。 | SkullServoFixV5 を Hole Horizontal Expansion +0.3 で再印刷し、ポケット短辺が29.6mm以上になることを実測で確認する。または耐水ペーパー#400で削り、HS-805BB現物が収まることを確認する。NeckServoHolderV2 については別途、STL上のポケット内寸を確認する。 | 解決日: 2026-08-11 | `docs/L/servo_assignment_L.md`、`docs/L/print_record_L.md` |
| 13 | 【解決済み・2026-08-06】MG92B予備2個の配分方針決定（R系予備 or S系ベンチ軸） | 中 | 2026-08-06に案(a)を正式採用。在庫MG92B×5個を R系3軸（upperLip／cheekRight／cheekLeft）＋S系ベンチ2軸（tasteSensorLift／throatGate）へ配分し、R系の予備は持たない。部品表の記載（高荷重5軸→MG92B×5）と一致する。ただしS系ベンチ2軸は液体を扱う環境で使用するため故障確率が相対的に高く、故障時は再発注（リードタイムを許容）する方針とする。 | 部品表の案(a)前提を正式決定として承認するか、案(b)へ変更し追加調達するかを確認する | 解決日: 2026-08-06 | `docs/R/reserved_axes.md`、`docs/S/bench_axes_S3S4.md` |
| 14 | 喉ゲートの非通電時閉機構 | 中 | 未決定（ばね等の機構案のみ） | 機構設計・実装。停止シーケンスでの閉動作保証との両立を検討 | 未定 | `docs/S/bench_axes_S3S4.md` |
| 15 | 過熱閾値・BMS低電圧閾値の具体的数値の決定 | 中 | 未決定。基板温度センサーの実装位置未確定、BMS型式未選定のため電圧閾値も未定 | 基板温度センサー実装位置確定後に温度閾値を設定。BMS型式選定後に電圧閾値を設定 | 未定 | `docs/S/safety_logic.md` |
| 32 | 左右独立サーボのソフトウェア同期の実装 | 中 | 目の左右8軸は機械的に連動せず、`inmoov.fr/eyes-i2/` によれば本来MyRobotLab側のソフトウェア同期で左右を揃える設計（本リポジトリはArduino Mega直接制御のためMyRobotLabを使用しない）。同期ロジック（左右の目を同時に動かす際の同期方式）が未実装 | 第2層（Mega）ファームウェアで左右同期ロジックを実装し、実機で目視確認する | L4実装時（同上） | `docs/L/channel_map_L.md`、`docs/L/servo_assignment_L.md` |
| 33 | 【解決済み・2026-08-06】瞼へのSG92R使用可否（公式がSG90級を非推奨） | 中 | 2026-08-06、公式i2Headチュートリアルの部品リストにより決着。公式は頭部に「15 servos JX PDI 1109MG (avoid using cheap SG90, they won't last long)」を指定しており、SG90級を名指しで非推奨としている。SG92RはTowerPro自身がSG90の新版と説明する製品であるため、**瞼4軸へのSG92R充当は却下する。** 瞼はJX PDI-1109MGを採用する。在庫のSG92R×8は眉×2・額×2（R系4軸）＋予備4として扱う。 | SG92Rの実機耐久試験、または公式指定JX PDI-1109MGへの統一を検討する | 解決日: 2026-08-06 | `docs/L/servo_assignment_L.md` §2.1 |
| 34 | 手順書成果物 S_PowerCut_TestReport_v1 未作成 | 中 | 蓮冥頭部 開発手順書 Version 2.1（2026-08-06）が定義する電源遮断試験報告書が未作成。実機試験後に作成予定 | 実機での電源遮断試験を実施し、報告書を作成する | L2完了ゲート前 | `docs/README.md`、`docs/S/power_tree.md` |
| 35 | 手順書成果物 L_NeckRotate_Baseline_v1 未作成 | 中 | 蓮冥頭部 開発手順書 Version 2.1（2026-08-06）が定義する首回転ベースライン記録（L2実機試験の記録）が未作成 | L2実機試験を実施し、記録を作成する | L2完了ゲート前 | `docs/README.md`、`docs/L/servo_assignment_L.md` |
| 36 | 手順書成果物 L2_PartsScale_Record_v1 未作成 | 中 | 蓮冥頭部 開発手順書 Version 2.1（2026-08-06）が定義するL2部品スケール記録が未作成 | L2部品のスケール記録を作成する | L2完了ゲート前 | `docs/README.md` |
| 37 | 手順書成果物 L2_Wiring_and_Stop_Test_v1 未作成 | 中 | 蓮冥頭部 開発手順書 Version 2.1（2026-08-06）が定義するL2配線・停止試験記録が未作成 | L2の配線・E-STOP動作試験を実施し、記録を作成する | L2完了ゲート前 | `docs/README.md`、`docs/S/safety_logic.md` |
| 40 | 【解決済み・2026-08-11】i2Head/Neck組立に必要なネジの不足 | 中 | 公式i2Headチュートリアルから抽出した必要ネジと在庫の照合結果、以下が不足している。M3×20（TopTeeth固定ほか2箇所）、M3×10（Jaw固定4本）、4mm×20（TopSkull上部2本）。在庫があるのはM3×16（未使用24本）および木ネジ詰合せ（M2〜M3、500本）。公式部品リストにはこのほか M3六角ナット6個、M3×14皿ネジ6本、0.8×6mmタッピング6本、4g×6.5mm皿タッピング4本、M3×20を2本の記載があり、在庫との突合が未完了。2026-08-06、公式 Hardware and BOM（https://inmoov.fr/default-hardware-map/、取得日2026-08-06）に全身分のネジリストが存在することを確認した。記載内容は「Screw Allen countersunk: M3x20MM about 50 / M4x20MM about 50 / M8x100MM about 15」「Phillips Flat-Head Wood Screws: M3x12MM about 100 for small servos / M4x20MM about 50 for big servos」である。**これは全身分の数量であり、頭部のみの必要数は別途精査が必要。**また皿頭（countersunk）指定であることが明確になった。i2Headチュートリアル側は M3×16／M3×20／M3×10／4mm×20 を個別に指定しており、両者の突合も未了である。**【2026-08-11 解決】** M3×20、M3×10、M4×20 の皿小ねじを調達した（いずれもステンレス、モノタロウ）。M3ナットは在庫12個で充足するため追加調達しない。なお公式 Hardware and BOM のネジリストは全身分の数量であり、頭部のみの必要数の精査は行っていない。組立時に不足が判明した場合は追加調達する。 | 公式i2Head部品リストと部品表を1件ずつ突合し、不足分をHS-805BBと同時に発注する | 解決日: 2026-08-11 | 部品表、`docs/OPEN_ISSUES.md` |
| 41 | 【解決済み・2026-08-06】PTC（RXEF250相当）の紛失・再調達 | 中 | 部品表には「ポリスイッチ PTC-RXEF72 定格2.5A」として在庫があるとされていたが、2026-08-06に現物を確認したところ紛失しており在庫ゼロである。設計上、レールA・レールBの各降圧入力側に1本ずつ、計2本が必要（`docs/S/power_tree.md` §5・§7-5）。なお部品表の型番表記「RXEF72」は誤りで、72は保持電流ではなく耐圧72Vを指す。正しい型番は**RXEF250**（保持2.5A／トリップ5.0A／72VDC／初期抵抗0.05Ω）である。部品表側の型番表記の訂正も必要。2026-08-06、RXEF250を再調達した。**現物の刻印による型番確認は未実施**であり、到着後に確認すること。部品表の型番表記を「RXEF72」から「RXEF250」へ訂正する作業も未了。 | RXEF250を2本以上（予備を含め4本を推奨）再調達し、現物の刻印で型番を確認する | 解決日: 2026-08-06 | 部品表、`docs/S/power_tree.md` §7-5 |
| 39 | 新首機構（New Neck）の公式組立手順が存在しない（サーボ規格は確定済み） | 中 | 手順書のL3部品（NeckV3／NeckJointLowerV5／NeckServoHolderV2／NeckServoPivotV2／NeckBoltsV2／ThroatHolderV2／ThroatHoleV3）はInMoovのNew Neck mechanismの部品である。公式Neck and Jawチュートリアルは「Gallery からダウンロード可能だが以下のチュートリアルには示されていない」と明記し、newNeck.mp4 のみを提供している。設計者Gael Langevin自身もInMoov公式Googleグループで新首のファイルはGalleryにあるが組立手順を作る時間がなかったと述べている（コミュニティ情報。公式サイト上の一次記述ではない）。動画にはサーボが映っておらず、使用サーボの公式明示がない。~~ただし2026-08-06のNeckServoHolderV2ポケット実測（65.7×29.3）がHS-805BB実寸（65.6×29.6）と一致したため、**首上下サーボはHS-805BBであると実測から判断する**（`docs/L/print_record_L.md` §3）。~~ **【2026-08-06 撤回】** 上記の判断は誤りである。実測した部品は NeckServoHolderV2 ではなく SkullServoFixV5 であった。さらにスライサー上で確認した NeckServoHolderV2 の外形は **55.0 × 58.5 × 22.0 mm** であり、HS-805BB の外形（65.6 × 29.6 × 57.4 mm）は長辺・高さともにこれを超えるため**物理的に収まらない**。**首上下軸のサーボは未確定である。** NeckServoHolderV2 の厚みが22.0mmであることから、標準サイズサーボ（厚み38mm前後）も収まらない可能性があり、マイクロサイズ（MG92B等、厚み29mm前後）を含めて再検討が必要である。まず NeckServoHolderV2 のSTL上でサーボポケット内寸（幅・奥行・深さ）を確認し、どの規格のサーボに対応するかを特定すること。なお首回転側（MainGear／NeckPlateHighV2／ServoGear／GearHolder／Ring／SkullServoFixV5）は公式i2Headチュートリアルに手順が記載されており、L2の実施に支障はない。2026-08-06にHS-805BBを2個調達済みだが、**確実に使用が決まっているのは首回転軸の1個のみ**である。残り1個の用途は首上下軸のサーボ規格が確定するまで未定とする。**【2026-08-06 サーボ確定】** InMoov公式 Hardware and BOM ページ（https://inmoov.fr/default-hardware-map/、取得日2026-08-06）に「2x Hitec HS805BB HEAD (up/down, right/left)」と明記されており、**首回転・首上下ともにHS-805BBで確定**した。同ページのコメント欄における設計者Gael Langevinの回答（2018-12-30）も「For the Neck and RotHead you need two HS805bb or some PDI-HV2060MG」としている。また NeckServoHolderV2.stl をBlenderで確認したところ、**同一形状のL字ブラケットが2個含まれており**、スライサー表示の外形55.0×58.5×22.0mmは2個分の合計である（1個あたり約55.0×28.0×22.0mm）。構造はサーボを内包する箱ではなく左右から挟むブラケットであるため、部品の厚み22mmはサーボ高さの制約にならない。2026-08-06に一時「NeckServoHolderV2にHS-805BBは収まらない」と判断したが、これはSTLに2個含まれることを見落とし、かつ構造を箱型と誤認したことによる誤りであり、撤回する。**組立手順が公式に存在しない点は未解決のまま継続する。**公式Neck and Jawチュートリアルは新首機構について「Galleryからダウンロード可能だが以下のチュートリアルには示されていない」と記載し、newNeck.mp4 のみを提供している。 | L3組立時に実機で検証し、判明した手順を `docs/L/` へ独自の組立記録として文書化する。 | L3着手時 | `docs/L/print_record_L.md`、L3関連文書 |

## 影響度：低

| # | 項目 | 影響度 | 現状 | 確認方法 | 期限 | 解決時に更新する文書 |
|---|---|---|---|---|---|---|
| 16 | MG92Bの高さ31mmの実測 | 低 | 未実測（R系のため2027年まで猶予） | 印刷済みサーボマウントに実測で当てる。入らなければSG92RかMG90Sへ変更 | 2027年R5着手前 | `docs/reference/servo_datasheets.md` |
| 17 | 目・瞼8軸（JX PDI-1109MG候補）の5V時トルク実測 | 低 | 線形補間値（JX PDI-1109MG 約2.25kg·cm、要求上限2.5kg·cmの約90%）のみで未実測。在庫MG90Sを併用する場合は約1.84kg·cm（同約74%）。旧記載「eyeX／eyeY／eyelid×2（MG90S）」は目の軸数訂正（#30）が未反映だったため2026-08-06に修正 ※**影響度の再判定が必要**（4軸→8軸化、かつトルク余裕が要求上限の約90%のため） | 実機トルク計測 | L4（手順書のL-Phase 2は首回転のみ。目はL-Phase 4のため） | `docs/L/servo_assignment_L.md`、`docs/reference/servo_datasheets.md` |
| 18 | パルスmin/max・中立パルスのキャリブレーション実測 | 低 | 未実測（標準値1500µsを仮定） | 実機キャリブレーション | 実装時 | `docs/L/channel_map_L.md` |
| 19 | コネクタ・延長ケーブル長の確定 | 低 | 未定 | 配線設計時に決定 | 未定 | `docs/L/channel_map_L.md` |
| 20 | rollNeckRight／rollNeckLeftを採用する場合の系統決定 | 低 | 未定（L系かR系か未確定）。2026-08-06、公式 Hardware and BOM により RollNeck（首傾げ）のサーボが「2x servos HK15298B NECK TILTING(1 Master, 1 slave)」と判明した（JX PDI-6221MG 180° でも代替可、設計者回答2018-12-30）。また設計者は本機構について Bob Huston によるサードパーティ改造部品の使用を案内しており（2017-02-03の回答）、公式標準部品のみでは構成できない可能性がある。**L系では未採用の方針を維持する。** サードパーティ部品はライセンス由来が公式と異なるため、採用する場合は `docs/decisions/2026-08-06_lr_repository_policy.md` の由来管理方針に従い別途確認が必要である。 | i2首傾げオプションの採用可否を判断 | 未定 | `docs/L/channel_map_L.md` |
| 21 | R系ボード・レールの物理分離方式 | 低 | 文書上の分離のみ（2026年） | 2027年R5着手時に物理分離方式を設計 | 2027年R5 | `docs/R/reserved_axes.md` |
| 22 | 表情プリセット・顎モジュールモードの具体値定義 | 低 | 軸名・モード名のみ申し送り済み。角度・パルス幅は未定義 | R系頭部設計時に新規定義（InMoov由来の値を持ち込まない） | 2027年R5以降 | `docs/R/reserved_axes.md` |
| 23 | 防水温度センサーの型式確定 | 低 | 未定 | 部品選定 | 未定 | `docs/S/bench_axes_S3S4.md` |
| 24 | Sub-callアドレスの基板ごとの割当方針 | 低 | 未使用（工場出荷時デフォルトで無効）。将来使用時に基板間の重複回避が必要 | 使用開始時に基板ごとに異なるSUBADR値を割り当てる | 未定 | `docs/S/i2c_address_map.md` |
| 25 | CAN／RS-485トランシーバの選定（ECI-v1） | 低 | 未定 | 候補比較・選定 | 未定 | `docs/S/mcu_pinmap.md` |
| 26 | MG90S外形寸法の公式図面再確認 | 低 | 複数ソース間で寸法値に差異あり（22.8×12.2×28.5mm採用、公式図面での再確認は未実施） | TowerPro公式図面の直接確認 | 未定 | `docs/reference/servo_datasheets.md` |
| 27 | 【解決済み・2026-08-11】94%スケールで作成されたBlenderモデルが100%へ更新済みか | 低 | 移行元文書からは確認できない。確認の結果94%のまま残っている部品が見つかった場合は、`docs/L/failure_log/scale_94.md` §5（手順書1.2、混在部品の扱い）の運用規則を適用する。**【2026-08-11 解決】** Blender 上の現行モデルを確認し、94%スケールのモデルは残存していないことを確認した。印刷済み部品についても、SkullServoFixV5 の再印刷を除き、すべて 100% スケールで出力されている。 | 現行3Dモデルのスケールを確認。混在が見つかった場合は`docs/L/failure_log/scale_94.md` §5に従い対応する。印刷済み部品については `docs/L/print_record_L.md` §2・§3 の記録作業と併せて確認する | 解決日: 2026-08-11 | `docs/L/failure_log/scale_94.md` §5 |
| 28 | 【解決済み・2026-08-06】CALIBRATOR比較の詳細記録の所在確認 | 低 | 旧資料を捜索したが、CALIBRATOR比較の詳細記録は存在しないことを確定した。CALIBRATOR現物も紛失。再印刷は行わない。再印刷して測り直しても新規測定値が得られるだけで、2026年7月の判断根拠を復元しないため。代替として、印刷済み実部品の実測記録を `docs/L/print_record_L.md` §3 で作成する。採用スケール100%という結論自体は、現行の印刷部品が嵌合している事実により実地で裏付けられている。 | 旧資料を捜索し、無ければ「記録なし」を確定させる | 解決日: 2026-08-06 | `docs/L/failure_log/scale_94.md`、`docs/L/print_record_L.md` |
| 29 | AIコンピュータ搭載後の稼働時間再計算・電源変換効率の実測 | 低 | AIコンピュータ未実装。効率値（η_A≈0.80、η_B≈0.90等）はデータシート代表値・線形補間であり未実測 | AIコンピュータ選定後に実機で稼働時間・変換効率を実測し再計算 | 第1層実装時 | `docs/S/power_tree.md` |

---

## 変更履歴

- **v1 2026-08-04** L/R/S/M体系への移行に伴い新規作成。各文書からの登録対象29件を影響度別（高6件・中9件・低14件）に一覧化した。
  - #13を「MG92B追加調達」の断定から、案(a)(b)の配分方針決定へ修正（`docs/R/reserved_axes.md`・`docs/S/bench_axes_S3S4.md` と整合）。
- **v1.1 2026-08-04** `inmoov.fr/eyes-i2/` の一次情報により目の軸数の誤りを発見。#30を「未確認」から「解決済み」へ更新し（目は眼球4軸＋瞼4軸＝計8軸、公式指定JX PDI-1109MG）、波及した新規項目として#31（目サーボ4本の追加調達、高）・#32（左右独立サーボのソフトウェア同期実装、中）・#33（瞼へのSG92R使用可否、中）を追加した。計33件（高8件・中11件・低14件）。経緯は `docs/decisions/2026-08-04_eye_axis_count_correction.md` を参照。
- **v1.2 2026-08-05** #9（PTCの保護協調の整理）の現状を更新。目の8軸化に伴いレールAの理論上限電流が2.8A→5.6Aとなり、PTCのトリップ電流5.0Aを初めて上回った事実を反映したが、トリップ時間15.6秒がLM2596の破壊域に対して遅すぎるため「PTCはレギュレータ自体を保護しない」という結論自体は不変（`docs/S/power_tree.md` §7-5(a)参照）。
- **v1.3 2026-08-05** #13（MG92B予備2個の配分方針決定）の現状を「未決」から「部品表では案(a)が前提。正式採否を確認する」へ更新。部品表の「高荷重5軸→MG92B×5」の記載が案(a)を前提としている事実を明記し、`docs/R/reserved_axes.md`・`docs/S/bench_axes_S3S4.md` と整合させた。
- **v1.4 2026-08-05** 蓮冥頭部 開発手順書 Version 2.0（2026-08-03）の成果物名対応を `docs/README.md` へ追加したのに伴い、未作成の4件（S_PowerCut_TestReport_v1／L_NeckRotate_Baseline_v1／L2_PartsScale_Record_v1／L2_Wiring_and_Stop_Test_v1）を#34〜#37として影響度「中」で新規登録した。L2完了ゲートに必要な成果物であるため。計37件（高8件・中15件・低14件）。本書の位置づけの対象文書一覧へ `docs/README.md` を追加。
- **v1.5 2026-08-05** #27を `docs/L/failure_log/scale_94.md` §5（手順書1.2、混在部品の扱いの運用規則）と相互参照させた。
- **v1.6 2026-08-06** 目の軸数訂正（8軸）の反映漏れを修正：#10の現状を「4軸／2.8A」から「8軸／5.6A」へ、#17の項目名・現状・期限を8軸化に合わせて更新（影響度の再判定が必要な旨を付記）。
- **v1.7 2026-08-06** #31〜#33の期限を「L2実装前後」から「L4実装前後」へ修正（手順書のL-Phase 2は首回転のみ、目はL-Phase 4のため）。L0/L1成果物7件がリポジトリに未収録である事実を#38（影響度：高）として新規登録した。計38件（高9件・中15件・低14件）。
- **v1.8 2026-08-06** 手順書§1.5改訂に伴い、#34〜#37の現状列の版数表記を「Version 2.0（2026-08-03）」から「Version 2.1（2026-08-06）」へ更新した。
- **v1.9 2026-08-06** #13（MG92B予備2個の配分方針決定）を解決済みとした。案(a)（在庫5個をR系3軸＋S系ベンチ2軸へ配分し、R系は予備なし）を正式採用し、項目名に「【解決済み・2026-08-06】」を付した。
- **v1.10 2026-08-06** `docs/L/channel_map_L2.md`・`docs/L/servo_assignment_L2.md` のリネームに伴い、本書内の相互参照を `docs/L/channel_map_L.md`・`docs/L/servo_assignment_L.md` へ更新した（内容の変更はない）。
- **v1.11 2026-08-06** #28（CALIBRATOR比較の詳細記録の所在確認）を解決済みとした（記録は存在しないことを確定。代替として `docs/L/print_record_L.md` §3 で実測記録を作成する方針）。#7（PCA9685のAll Callアドレス2枚重複）を実装済み・実機未検証とした（`firmware/ServoCenter.ino` にdisableAllCall関数を実装）。#38（L0/L1成果物7件がリポジトリ未収録）の現状にServoCenter.ino／servo_pin_map.csv再作成版のfirmware/収録を追記（未解決のまま継続）。#27（94%スケールのBlenderモデル確認）の確認方法へ `docs/L/print_record_L.md` との併用を追記。件数に変更なし（計38件・高9件・中15件・低14件）。
- **v1.12 2026-08-06** #12（NeckServoHolderV2／SkullServoFixV5の実寸照合）へNeckServoHolderV2ポケットの実測結果（長辺+0.1mm、短辺-0.3mm）を反映し、確認方法・期限・解決時に更新する文書を更新した（解決はしない）。#33（瞼へのSG92R使用可否）を公式i2Headチュートリアルの部品リストにより解決済みとし、瞼4軸をJX PDI-1109MGで確定した。#31（目サーボ4本の追加調達）へ瞼確定の反映を追記。#6（首サーボ5V時トルク実測）へ発注保留をしない方針を追記。新規項目として#39（新首機構の公式組立手順が存在しない、中）・#40（i2Head/Neck組立に必要なネジの不足、中）を追加した。計40件（高9件・中17件・低14件）。
- **v1.13 2026-08-06** #11（jaw候補（MG996R／DS3218MG）の最終決定）を差し替え。公式i2Headチュートリアルの精読により顎サーボの公式指定が JX PDI-6221MG（180°）であることが判明したため、項目名を「顎サーボの選定（公式指定 JX PDI-6221MG）」に変更し、現状・確認方法を更新した。`firmware/servo_pin_map.csv`・`docs/L/channel_map_L.md` に記載済みの「旧候補MG996R/DS3218MGは2026-08-06に却下（#11）」との文書間矛盾を解消した。影響度を中から高へ変更し、影響度「高」テーブル末尾へ移動した（L-Phase 5の設計前提が変わるため）。解決時に更新する文書へ `firmware/servo_pin_map.csv` を追加した。件数を実数で数え直し、計40件（高10件・中16件・低14件）に更新した。
- **v1.14 2026-08-06** #1（独立安全コントローラ（第3層）の選定）の現状へ、第3層に在庫のArduino Mega 2560の2枚目を充てることを決定した旨（`docs/decisions/2026-08-06_layer3_controller_selection.md`）を追記した。実配線・ファームウェア・ハートビート監視の実装・動作検証はすべて未着手であり、**共倒れ構造は現時点では解消していないため、本項目は未解決のまま継続する。**確認方法へ実機確認の方法を追記し、解決時に更新する文書へ決定記録を追加した。
- **v1.15 2026-08-06** #3（12V母線の逆接保護）へ、案1（理想ダイオードコントローラ＋NチャネルMOSFET）を正式採用した旨を追記した（型番未確定・部品未入手・実装未着手のため未解決のまま継続、期限を「12V母線の実配線前」へ変更）。#4（E-STOP後の残留エネルギー放電経路）へ、ブリーダ抵抗（10kΩ/1/4W ×2）の設計値を決定した旨を追記した（未実装のため未解決のまま継続）。PTC（RXEF250相当）の現物紛失・在庫ゼロを新規項目#41（影響度：中）として登録し、部品表の型番表記「RXEF72」の誤り（正しくはRXEF250、72は耐圧72Vを指す）も併記した。件数を実数で数え直し、計41件（高10件・中17件・低14件）に更新した。
- **v1.16 2026-08-06** #3（12V母線の逆接保護）へ、同日中に案1からPチャネルMOSFET方式（2SJ334＋ツェナー＋ゲート抵抗100kΩ）へ変更した旨を追記した（部品は調達済みだが実装・検証は未着手のため未解決のまま継続）。#11（顎サーボの選定）へ、JX PDI-6221MGを1個調達しトルク値が判明した旨（出典は販売店の商品説明、メーカー公式データシートによる確認は未実施）と、120°／180°／360°の別モデルが存在し現物が180°版であるかの確認が未実施である旨を追記し、確認方法を実機到着後の動作角確認・嵌合確認へ更新した。#41（PTC紛失・再調達）を解決済みとし、RXEF250を再調達した旨（現物の刻印による型番確認・部品表の型番訂正は未了）を追記、期限を「解決日: 2026-08-06」へ変更した。件数に変更なし（計41件・高10件・中17件・低14件）。
- **v1.17 2026-08-06** #12（NeckServoHolderV2／SkullServoFixV5の実寸照合）の現状を訂正した。2026-08-06に実測した部品はNeckServoHolderV2ではなくSkullServoFixV5であり、部品名の取り違えであった（NeckServoHolderV2は未実測のまま）。確認方法をSkullServoFixV5の再印刷・研磨に訂正した。#39（新首機構の公式組立手順が存在しない）の「NeckServoHolderV2ポケット実測によりHS-805BBで確定」という判断を撤回した。実測した部品はSkullServoFixV5であり、スライサー上で確認したNeckServoHolderV2の外形（55.0×58.5×22.0mm）にはHS-805BB（65.6×29.6×57.4mm）が物理的に収まらないため、首上下軸のサーボは未確定へ戻した。影響度を中から高へ変更し、影響度「高」テーブル末尾へ移動した（既にHS-805BBを2個調達済みであり調達判断に直接影響するため）。確認方法・期限を更新した。件数を実数で数え直し、計41件（高11件・中16件・低14件）に更新した。
- **v1.18 2026-08-06** #39（新首機構の公式組立手順が存在しない）を訂正した。v1.17の「NeckServoHolderV2にHS-805BBは物理的に収まらない」という判断は、NeckServoHolderV2.stlに同一形状のL字ブラケットが2個含まれていることを見落とし、外形寸法をスライサー表示の合計値のまま単一部品の寸法と誤認したことによる誤りであった。1個あたりの外形は約55.0×28.0×22.0mmであり、構造は左右から挟むブラケットのため厚み22mmはサーボ高さの制約にならない。InMoov公式 Hardware and BOM ページ（https://inmoov.fr/default-hardware-map/、取得日2026-08-06）の「2x Hitec HS805BB HEAD (up/down, right/left)」の記載により、**首回転・首上下ともにHS-805BBで確定**した。項目名を「新首機構（New Neck）の公式組立手順が存在しない（サーボ規格は確定済み）」に変更し、確認方法・期限を更新した上で、影響度を高から中へ戻した（サーボが確定し調達判断への影響が消えたため。組立手順が公式に存在しない点は未解決のまま継続する）。件数を実数で数え直し、計41件（高10件・中17件・低14件）に更新した。
- **v1.19 2026-08-06** #11（顎サーボの選定）へ、InMoov公式 Hardware and BOMページの「1x servos HK15298B JAW MECHANISM」の記載と、設計者Gael Langevinの回答（2018-12-30）「For the jaw you need one HK15298B or some (PDI-6221MG, make sure to get 180°)」により、JX PDI-6221MG（180°）が公式に認められた代替であることが確定した旨を追記した。#40（ネジ不足）へ、公式Hardware and BOMのネジリスト（全身分の数量、頭部のみの必要数は別途精査要）を追記した。#20（RollNeck採否）へ、公式BOMによるRollNeckサーボ「2x servos HK15298B NECK TILTING」の判明とL系未採用方針の維持を追記した。件数に変更なし（計41件・高10件・中17件・低14件）。
- **v1.20 2026-08-11** #12（NeckServoHolderV2／SkullServoFixV5の実寸とサーボ外形の照合）を解決済みとした。Hole Horizontal Expansion +0.3mmでSkullServoFixV5を再印刷し、ポケット短辺30.1mmを実測（`docs/L/print_record_L.md` §3）。#27（94%スケールBlenderモデルの確認）を解決済みとした。現行Blenderモデルに94%スケールの残存が無いことを確認した。#40（i2Head/Neck組立ネジ不足）を解決済みとした。M3×20／M3×10／M4×20の皿小ねじを調達した（M3ナットは在庫充足）。件数に変更なし（計41件・高10件・中17件・低14件）。
- **v1.21 2026-08-11** #8（プリチャージ回路の実装方式・BMS型式・主電源SWのinrush定格確認）へ、実装方式の決定（在庫の12V 20Aミニロッカースイッチ2個による2段階投入方式、`docs/S/power_tree.md` §7-2）を追記した。リレーによるバイパス方式は却下した理由とともに記録した。未実装であり本項目は解決済みとしない。件数に変更なし（計41件・高10件・中17件・低14件）。

## 参照一覧

全項目の出典は「解決時に更新する文書」列に記載の各文書を参照。旧文書からの直接引用は無い（本書は各新文書からの集約のみ）。
