chinochino66/humanoid/docs/L/failure_log/scale_94.md

# 失敗記録：94%スケール不採用

版数: v1.3
改訂日: 2026-08-06
準拠文書: 器創造計画 2026-2033（改訂基準日 2026-08-03）
系統タグ: L（InMoov 100%学習機。頭部スケール決定の記録）
変更履歴:
- v1 2026-08-04 旧H-Phase体系文書（`docs/archive/2026-08-03_power_system_hphase.md` §0の注記、`docs/archive/2026-08-03_servo_comparison_hphase.md` 表題）に断片的に残っていた94%スケール不採用の経緯を、失敗記録として新規に切り出した。
- **v1.1 2026-08-05** §5「運用規則（手順書1.2、混在部品の扱い）」を新規追加。蓮冥頭部 開発手順書 Version 2.1（2026-08-06）§1.2の混在部品の扱い（100%履歴が確認できる部品はそのまま使用し、94%・履歴不明の部品は嵌合部品群のみ100%で再印刷、L0-L1のやり直しは不要）を出典明記で転記し、`docs/OPEN_ISSUES.md` #27 と相互参照させた。
- **v1.2 2026-08-06** 手順書§1.5改訂に伴い、§5の「出典：」行および変更履歴v1.1の記述の版数表記を「Version 2.0（2026-08-03）」から「Version 2.1（2026-08-06）」へ更新した。

---

## 1. 何があったか（旧文書からの確認事実）

- 旧H-Phase体系のH-Phase 0で、頭部のBlender空間予約（3Dモデル上での機構配置検討）を**94%スケール**を基準に作成した。
- その後のH-Phase 1で「CALIBRATOR」比較を行い、**100%スケールの採用が確定した**（`docs/archive/2026-08-03_power_system_hphase.md` 冒頭「採用スケール: 100%（H-Phase 1 CALIBRATOR比較にて確定）」、`docs/archive/2026-08-03_servo_comparison_hphase.md` 表題「頭部フェーズ／スケール100%」）。
- 結果として、94%基準で作成済みだったBlender空間予約は、100%採用に伴い**再作成が必要**になった（旧文書に「⚠ H-Phase 0のBlender空間予約は94%基準で作成されているため、100%採用に伴う再作成が必要。別課題として管理する」と記載）。

**移行元文書に残っていない情報**：「CALIBRATOR比較」の具体的な比較項目・数値・判断過程は、移行対象の3文書（power_system／servo_comparison／channel_map、いずれも `docs/archive/` に退避済み）のいずれにも記録が見当たらない。名称のみが残っている状態であり、本書執筆時点で再現できない。

## 2. 何が失敗だったか

- **スケールに依存する成果物（空間予約）を、スケール確定前に暫定値（94%）で作り込んでしまった。**100%への変更が判明した時点で手戻り（Blenderモデルの再作成）が発生した。
- **重要な意思決定（スケール確定）の判断根拠が文書化されずに失われた。**「CALIBRATOR比較にて確定」という結論だけが残り、比較項目・数値・却下理由が追跡できない。今回のL/R/S/M移行でも、この経緯を裏付ける一次資料は見つからなかった。

## 3. 教訓（今後の運用への反映）

- 空間予約・機構配置などスケールに依存する成果物は、**スケール確定を待ってから着手する。**確定前に着手する場合は、暫定値であることと、確定後に再作成が必要になり得ることを成果物自体に明記する。
- 重要な意思決定は、**判断根拠（比較項目・数値・結論）をその場で文書化する。**名称だけの記録は、後から検証も再利用もできず、失敗の再発防止に使えない。本移行で作成した文書群（`docs/decisions/2026-08-03_lrsm_migration.md` 等）は、この教訓を踏まえて意思決定の根拠を残す形式を踏襲している。

## 4. 現在の状態（2026-08-04時点、未確認）

採用スケール100%は確定済みであり、本移行後の文書（`docs/L/servo_assignment_L.md`・`docs/reference/servo_datasheets.md` 等）は100%スケール前提で作成した。ただし以下は移行元文書からは確認できず、`docs/OPEN_ISSUES.md` へ登録する：

- 94%基準で作成されたBlenderモデルが実際に100%へ更新済みかどうか（`docs/OPEN_ISSUES.md` #27）
- CALIBRATOR比較の詳細記録が別途どこかに存在するか（存在すれば本書へ転記し、存在しなければ「記録なし」を確定させる）

## 5. 運用規則（手順書1.2、混在部品の扱い）

出典：蓮冥頭部 開発手順書 Version 2.1（2026-08-06）§1.2

**スライサー履歴が100%と確認できる部品はそのまま使う。94%または履歴不明の部品は100%部品と組み合わせず、嵌合する部品群だけ100%で再印刷する。L0-L1を最初からやり直す必要はない。**

この規則は、#27（94%基準で作成されたBlenderモデルが実際に100%へ更新済みか未確認）の解決作業に直接適用する。#27の確認の結果、94%スケールのまま残っている部品が見つかった場合、本規則に従い対応すること：

- 対象部品のスライサー履歴を確認し、100%と確認できるものはそのまま使用する
- 94%または履歴不明の部品は、100%部品と混在させず、その部品と嵌合する部品群のみを100%で再印刷する
- L0-L1相当の作業（旧H-Phase体系でのBlender空間予約等の初期工程）をやり直す必要はない

→ `docs/OPEN_ISSUES.md` #27 と本節を相互参照する。

---

## 変更履歴

- **v1 2026-08-04** 旧H-Phase体系文書の断片的な記述から、94%スケール不採用の経緯を失敗記録として新規作成。詳細な判断根拠が記録として残っていないこと自体を教訓として明記した。
- **v1.1 2026-08-05** §5「運用規則（手順書1.2、混在部品の扱い）」を新規追加。蓮冥頭部 開発手順書 Version 2.1（2026-08-06）§1.2の混在部品の扱いを出典明記で転記し、`docs/OPEN_ISSUES.md` #27 と相互参照させた。
- **v1.2 2026-08-06** 手順書§1.5改訂に伴い、§5の「出典：」行および変更履歴v1.1の記述の版数表記を「Version 2.0（2026-08-03）」から「Version 2.1（2026-08-06）」へ更新した。
- **v1.3 2026-08-06** `docs/L/servo_assignment_L2.md` のリネームに伴い、本書内の相互参照を `docs/L/servo_assignment_L.md` へ更新した（内容の変更はない）。

## 参照一覧

| 資料 | URL | 取得日 |
|---|---|---|
| 旧文書 `docs/archive/2026-08-03_power_system_hphase.md`（§0冒頭の注記） | ローカルリポジトリ内 | 2026-08-03 |
| 旧文書 `docs/archive/2026-08-03_servo_comparison_hphase.md`（表題） | ローカルリポジトリ内 | 2026-08-03 |
| `docs/decisions/2026-08-03_lrsm_migration.md` | ローカルリポジトリ内 | 2026-08-04 |
| 蓮冥頭部 開発手順書 Version 2.0（2026-08-03）§1.2（混在部品の扱い） | ローカルリポジトリ内 | 2026-08-05 |
