chinochino66/humanoid/(commit log)

2026-07-28 docs: 電源系統図・サーボ比較・チャンネル表 v0
2026-07-28 docs: 電源系統図・サーボ比較・チャンネル表 v0 を追加
2026-07-28 docs: 電源系統図・チャンネル表 v0 を追加
2026-07-28 docs: チャンネル表 v0 を追加
2026-07-29 12V母線の下にE-STOPを入れ、その下の全アクチュエータをソフトに頼らず停止できるようにする
    Updated E-STOP description and modified connections to the pump.
2026-07-29 変更履歴: v0.1 2026-07-29 E-STOPを12V母線直後へ移動、ポンプ系を遮断下流へ
2026-07-30 fix: Eyes i2は目2軸・瞼2軸の連動構成のためPCA#1を4ch削減
2026-07-30 chore: channel_map_v0.mdのBOMを除去
2026-07-31 PCを機体の中に入れる
    Added tasks for system integration and power management.
2026-07-31 稼働時間をのばす
    Added definition for standby state to improve power efficiency.
2026-08-03 docs: 改訂手順書(H-Phase 0-24)へ準拠。制御四層・独立安全コントローラ・BMS・将来顎電力系を反映
2026-08-03 docs: 系統図を電力図と制御通信図へ分離、ラベル折り返しで文字切れを解消
2026-08-03 chore: 旧3文書をdocs/archive/へ退避（旧H-Phase体系のため）
2026-08-04 docs: L/R/S/M体系のdocs/README.mdと移行決定記録を追加、.claude/を追跡除外
    - docs/README.md: L/R/S/M体系、ディレクトリ構成、知財境界を明示
    - docs/archive/README.md: 旧H-Phase文書の退避理由を記録
    - docs/decisions/2026-08-03_lrsm_migration.md: 体系移行の経緯・理由・
    知財上の根拠・修正した設計誤り一覧を記録
    - .gitignore: .claude/ を追加（認証情報等の混入を避けるため追跡除外）
2026-08-04 docs: 電源系統図をS系として再構成（稼働時間計算の測定点誤りを修正）
    - レールAの負荷モデルを2026年実装範囲（目2軸+瞼2軸=4ch）へ修正。
    旧文書はR系軸（表情7ch、2027年R5-R9）と同居しており系統分離に違反していた
    - 稼働時間計算の測定点誤りを修正し、レールA修正後の値で再計算
    （旧: 誤った方法で3.7h → 新: 定常約6.1h、全軸ピーク継続で下限約1.8h）
    - プリチャージ抵抗「未使用」の判断を再検討。BMS誤トリップ・主電源SW接点
    溶着リスクが未確認である点と部品在庫を踏まえ「使用する」方針へ変更し、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
2026-08-04 docs: サーボ諸元表とL2軸割当を分離、首サーボ保留を解除
    - docs/reference/servo_datasheets.md: 軸割当を含まない純粋な仕様表を新規作成。
    MG90S/SG92R/MG92B/MG996R/DS3218MG/HS-805BBの諸元をメーカー公式ページ等の
    一次情報で確認し、5.0V欄が無い機種は補間である旨を明記
    - docs/L/servo_assignment_L2.md: L2 InMoov頭部の対象7軸（eyeX/eyeY/eyelid×2/
    jaw/neckRotate/neckUpDown）のみを扱う軸割当を新規作成。決定1に従い首サーボ
    （HS-805BB×2）の発注保留を解除。非商用条件（Attribution-NonCommercial）と
    inmoov.fr出典を明記
    - 5.0V時トルクで再評価した結果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
2026-08-04 docs: チャンネル表をL/R/Sの3文書へ分割
    - docs/L/channel_map_L2.md: L系7ch（目・瞼・首・顎）のみを新規作成。
    R系・S系を1行も含めない。空きチャンネル集計とレール別電流予算の
    参照を追加。顎の試験角度15°とハードコード上限20°の区別を維持
    - docs/R/reserved_axes.md: R系予約軸7軸（表情系）を新規作成。
    在庫MG92B×5・SG92R×8を2027年R系向けとして紐付け。InMoov由来の
    形状・寸法・メッシュへの参照は一切含めない
    - docs/S/bench_axes_S3S4.md: throatGate/tasteSensorLift/ペリスタポンプ/
    漏水・満水・トレー検知/味覚JSONスキーマ/ESP32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
2026-08-04 docs: I²Cアドレスマップ・頭部全体の安全ロジック・Megaピン表を新規分離
    bench_axes_S3S4.md §6で「担当文書未確定」としていた項目の受け皿として
    3文書を新規作成し、コミット計画を全6→全7へ更新した。
    - docs/S/i2c_address_map.md: I²Cアドレス全体（PCA9685×2/INA219×2/ADS1115/
    TCS34725）、部品ごとのジャンパ・ハンダ変更箇所、PCA9685のAll Callアドレス
    重複（0x70、両基板同時応答）の扱いと無効化推奨、空きアドレス帯を整理
    - docs/S/safety_logic.md: 頭部全体の固定安全ロジック8条件（E-STOP/レール
    過電流/過熱/通信断/ハートビー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
2026-08-04 docs: 94%スケールを失敗記録として分離
    旧文書に断片的に残っていた「94%基準で空間予約→100%採用確定により
    再作成が必要」という経緯を失敗記録として切り出した。CALIBRATOR比較の
    詳細な判断根拠が記録として残っていないこと自体を教訓として明記し、
    未確認事項をdocs/OPEN_ISSUES.md登録対象とした。
2026-08-04 docs: OPEN_ISSUES.mdを追加
    移行過程で各文書に「docs/OPEN_ISSUES.md へ登録」と記した項目を、
    影響度（高/中/低）別に横断管理する一覧として新規作成。
    最低限必須の8項目（頭部質量実測、12V母線逆接保護、E-STOP残留エネルギー、
    独立安全コントローラ選定、PCA9685 All Call重複、プリチャージ根拠、
    PTC保護協調、MG92B高さ実測）に加え、今回の移行作業中に発見した項目
    （首サーボ5V時トルクの僅差判定、レールA同時ストール制限、jaw候補の
    5V時トルク不足懸念、E-STOP第2層依存の未確認等）を含め、計29件を集約した。
2026-08-04 docs: safety_logic.mdに#2レール過電流の共倒れリスクを明記
    INA219はMegaのI²Cバス上にあり、Megaがハングすればバスのポーリングが
    止まるため、レール過電流の検知自体が機能しなくなる。#5ハートビート
    停止と同じ共倒れ構造であることを追記した。
2026-08-04 fix: 検証で発見した3件の未修正・不整合を修正
    1. forhead → forehead の綴り誤りを修正（5ファイル、7箇所）。R系は
    白紙CADの新規設計であり、InMoov公式パーツ名の誤字を踏襲する理由がない。
    docs/R/reserved_axes.md, docs/L/channel_map_L2.md, docs/S/power_tree.md,
    docs/L/servo_assignment_L2.md
    2. MG92B数量の矛盾を解消。bench_axes_S3S4.mdが「別途調達が必要」と
    断定していたが、R系予備2個(reserved_axes.md)でS系ベンチ軸2軸分は
    数量上足りるため、断定を撤回し案(a)R系予備をS系へ充当／案(b)別途
    調達しR系予備を維持、の2案併記へ変更。r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
2026-08-04 fix: 目の軸数誤り（4軸→8軸）を一次情報で訂正
    inmoov.fr/eyes-i2/ を一次情報で確認した結果、目関連軸を
    「eyeX/eyeY共通2軸＋瞼2軸＝計4軸」としていたのは誤りで、正しくは
    「片目4サーボ（眼球X/Y・上瞼・下瞼）×左右＝計8軸、左右独立・
    ソフトウェア同期（機械連動ではない）」と判明した。公式指定サーボは
    JX PDI-1109MGであり、「安価なSG90は避けろ」との警告も確認した。
    - docs/reference/servo_datasheets.md: JX PDI-1109MGの諸元を追加
    - docs/L/channel_map_L2.md: L系チャンネル数を7ch→11chへ拡張
    （目8ch: ch7-10眼球+ch12-15瞼）。空き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
2026-08-05 fix: 8軸化に伴うPTC保護協調の事実関係を更新（結論は不変）
2026-08-05 fix: OPEN_ISSUES #9にPTC保護協調の事実関係の変化を反映
    目の8軸化でレールA理論上限が2.8A→5.6Aとなりトリップ電流5.0Aを初めて
    超えたが、トリップ時間15.6秒がLM2596破壊域に対し遅すぎるため結論は不変。
2026-08-05 fix: MG92B配分方針を部品表の案(a)前提に整合
    OPEN_ISSUES #13を「未決」から「部品表では案(a)が前提。正式採否を確認する」
    へ更新し、docs/R/reserved_axes.md・docs/S/bench_axes_S3S4.mdの
    案(a)(b)併記箇所を部品表の実態（案aを既に前提としている）と整合させた。
2026-08-05 docs: 手順書成果物名との対応セクションをREADMEへ追加
    蓮冥頭部 開発手順書 Version 2.0（2026-08-03）の成果物名と本リポジトリ
    文書との対応表を追加し、未作成の4件をOPEN_ISSUESへ影響度「中」で登録
    （#34〜#37、L2完了ゲートに必要なため）。
2026-08-05 docs: scale_94.mdに手順書1.2の混在部品運用規則を追記
    出典を蓮冥頭部 開発手順書 Version 2.0 §1.2として明記し、
    OPEN_ISSUES #27と相互参照させた。
2026-08-05 docs: 目の軸数訂正(8軸)の反映漏れを修正 (README/OPEN_ISSUES #10,#17)
2026-08-05 docs: 調達済み品を買い足しリストから除外・D36V50F5定格に入力電圧条件を付記
2026-08-05 docs: L0/L1成果物のリポジトリ未収録を#38として登録・目関連の期限をL4へ訂正・ルートREADME整備
2026-08-05 docs: L2/L系設計文書をリネームし相互参照を追従、手順書v2.1参照更新・MG92B配分決定・リポジトリ運用方針の決定記録を追加
    - docs/L/channel_map_L2.md → docs/L/channel_map_L.md、docs/L/servo_assignment_L2.md → docs/L/servo_assignment_L.md へリネームし、リポジトリ全体の相互参照を追従。docs/README.mdへ「文書の命名規則」セクションを新設
    - 手順書§1.5改訂に伴い、蓮冥頭部 開発手順書の版数参照を「Version 2.0（2026-08-03）」から「Version 2.1（2026-08-06）」へ更新
    - docs/decisions/2026-08-06_lr_repository_policy.md を新規作成し、L系・R系を単一リポジトリ内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
2026-08-07 feat(firmware): ServoCenter.ino と servo_pin_map.csv を再作成版として収録
    [servo_pin_map.csv]
2026-08-07 docs: 印刷部品台帳 print_record_L.md を新設・cad/media の保存規則を整備
2026-08-07 docs: OPEN_ISSUES #28を解決済みに・#7を実装済み(未検証)に・#38の現状を更新
2026-08-09 docs: NeckServoHolderV2ポケット実測を記録・印刷収縮率-1.0%を確定 (#12)
2026-08-09 docs: 公式i2Head精読により顎サーボを6221MGへ・瞼を1109MGで確定 (#15,#31,#33)
    [servo_pin_map.csv]
2026-08-09 docs: 新首機構の手順欠如(#39)とネジ不足(#40)を登録・#6の発注方針を明記
2026-08-10 docs: print_record_L §2 の印刷状態をL2/L3実態に合わせて訂正
2026-08-10 docs: OPEN_ISSUES #11 を公式指定 JX PDI-6221MG へ差し替え・影響度を高へ
2026-08-10 docs: 第3層に2枚目のArduino Mega 2560を充てる決定を記録
2026-08-10 docs: safety_logic/mcu_pinmap へ第3層構成を反映・OPEN_ISSUES #1 を更新
2026-08-10 docs: 12V母線逆接保護に理想ダイオード方式を採用・ブリーダ抵抗10kΩを設計 (#3,#4)
2026-08-10 docs: 基板温度センサーを10kΩ NTCサーミスタで確定
2026-08-10 docs: PTC紛失を#41として登録・買い足しリストを更新
2026-08-10 docs: 逆接保護を理想ダイオードICからPchMOSFET(2SJ334)方式へ変更 (#3)
2026-08-10 docs: JX PDI-6221MGのトルク値を追記・180°版の確認を未了として記録 (#11)
2026-08-10 docs: 調達完了分を買い足しリストへ反映・PTC再調達で#41を解決
2026-08-10 docs: JX PDI-6221MGのトルク・寸法を追記・180°版の確認を未了として記録
2026-08-10 fix(docs): 実測値の部品名をNeckServoHolderV2からSkullServoFixV5へ訂正 (#12)
    2026-08-06に記録した実測値（長辺65.7mm/短辺29.3mm/角部高さ8.2mm）はNeckServoHolderV2のものとして記録したが、実際に測定した部品はSkullServoFixV5であった。docs/L/print_record_L.md §2・§3、docs/OPEN_ISSUES.md #12を訂正し、誤記録の経緯は削除せず訂正の事実として残した。
2026-08-10 fix(docs): 首上下サーボ=HS-805BBの判断を撤回・#39を影響度高へ
    実測した部品はNeckServoHolderV2ではなくSkullServoFixV5であり、NeckServoHolderV2の外形（スライサー確認55.0×58.5×22.0mm）にはHS-805BBが物理的に収まらない。首上下軸のサーボ確定判断を撤回し未確定へ戻す一方、首回転軸はSkullServoFixV5実測により確定のまま維持する。docs/OPEN_ISSUES.md #39を影響度中から高へ移動し、docs/L/channel_map_L.md・docs/L/servo_assignment_L.md・docs/reference/servo_datasheets.md・firmware/servo_pin_map.csvを整合させた。
    [servo_pin_map.csv]
2026-08-10 docs: 公式BOMにより首2軸をHS-805BBで確定・#39のサーボ未確定を解消
    NeckServoHolderV2.stlをBlenderで確認したところ同一形状のL字ブラケットが2個含まれており、以前の「HS-805BBが物理的に収まらない」という判断はスライサー外形表示（2個分の合計）を単一部品の寸法と誤認した誤りだった。InMoov公式Hardware and BOMページの「2x Hitec HS805BB HEAD (up/down, right/left)」の記載により、首回転・首上下ともにHS-805BBで確定し、docs/OPEN_ISSUES.md #39を影響度高から中へ戻した。docs/L/channel_map_L.md・docs/L/servo_assignment_L.md・docs/reference/servo_datasheets.md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
    [servo_pin_map.csv]
2026-08-10 docs: HK15298Bを参考情報として追加・公式ネジリストを#40へ反映
    InMoov公式Hardware and BOMページの精読により、docs/OPEN_ISSUES.md #11（顎サーボ）へJX PDI-6221MGが公式に認められた代替であることの根拠を追記し、#40（ネジ不足）へ全身分の公式ネジリストを追記し、#20（RollNeck採否）へ公式指定サーボとL系未採用方針を追記した。docs/reference/servo_datasheets.mdへHS-805BB・JX PDI-6221MGの公式用途・代替を追記し、新規にHK15298Bの項目を参考情報として追加した（本プロジェクトでは不採用）。
2026-08-11 docs: SkullServoFixV5再印刷の結果を記録・Hole Horizontal Expansionの実効値2倍を知見化
    Cura の Hole Horizontal Expansion +0.3mm でSkullServoFixV5を再印刷し、
    ポケット短辺30.1mmを実測。設定値+0.3mmに対し実測変化量+0.8mmであり、
    Cura の当該設定は内寸に対して設定値の約2倍が加算されると解される知見を記録した。
    再印刷条件・3MFを台帳に追加した。
    [L2_SkullServoFixV5_100pct_HHE+0.3_2026-08-06.3mf]
2026-08-11 docs: OPEN_ISSUES #12/#27/#40 を解決済みに
    #12: SkullServoFixV5再印刷でポケット短辺30.1mmを実測、HS-805BB収容可を確認。
    #27: 現行Blenderモデルに94%スケールの残存が無いことを確認。
    #40: M3×20／M3×10／M4×20の皿小ねじを調達（M3ナットは在庫充足）。
2026-08-11 docs: プリチャージ実装方式を2スイッチ方式で決定 (#8)
    在庫の12V 20Aミニロッカースイッチ2個による2段階投入方式（案a相当）を
    採用。追加調達なし。リレーによるバイパス方式は、コイル電源とタイマー回路が
    必要となり電源投入シーケンスが能動回路に依存するため却下した。未実装。
    あわせて §11 買い足しリストのネジ調達済み反映と、L2〜L3実装に必要な部品が
    すべて調達済み・在庫充足である旨の注記を追加した。
2026-08-11 docs: servo_pin_map の notes を結論先頭へ整理
    0x41 ch0(neckRotate)・ch1(neckUpDown)のnotes列で撤回と確定の経緯が
    時系列のまま並び結論が読み取りにくかったため、結論（HS-805BBで確定）を
    先頭に置き、経緯を保持したまま並べ替えた。
    [servo_pin_map.csv]
